TAPR/TICC/docs/images/TICC-test-setup.jpg

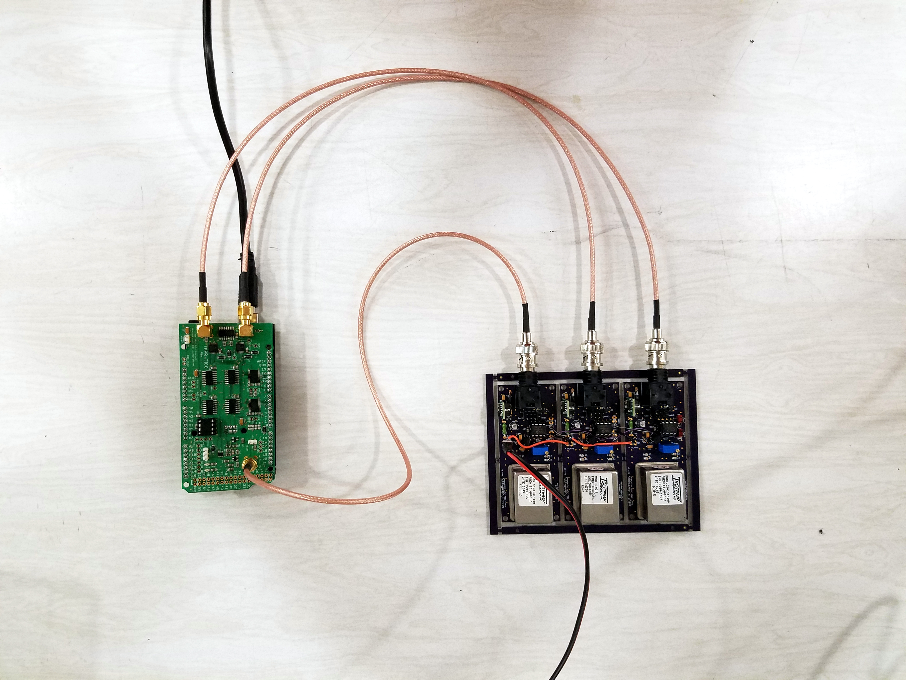
docs/images/TICC-test-setup.jpg
