TAPR/TICC/docs/images/PulsePuppy-Multi_medium.jpg

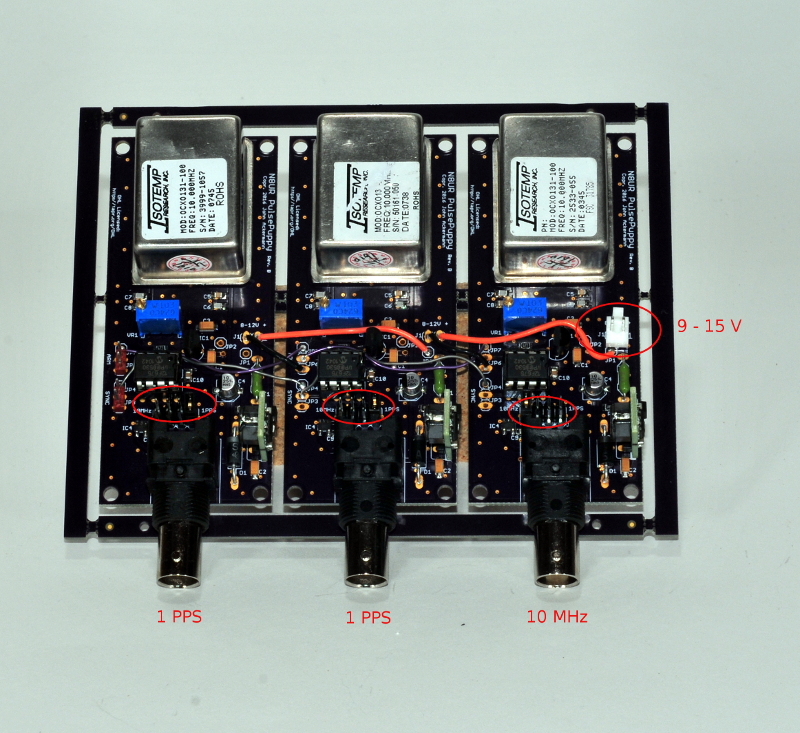
docs/images/PulsePuppy-Multi_medium.jpg
