TAPR/TICC/docs/TICC_architecture.md

# TICC Architecture Documentation

**Date:** November 16, 2025 

## Overview
This document describes the architecture and implementation details of 
the TAPR TICC timestamping counter hardware and firmware. The TICC uses 
Texas Instruments TDC7200 chips to provide precise timestamp measurements 
with picosecond accuracy.  It is a little disorganized but attempts to
describe all the important details of the system.

This firmware version includes performance optimizations applied after 
detailed oscilloscope-based performance analysis. Current measured 
performance:
- **Event processing:** 566 µs (from INTB assertion to calculate_timestamp
    return)
- **Timestamp formatting:** 395 µs (ASCII conversion for text output)
- **Measured sustainable throughput:** 
  - 587 measurements/second @ 115200 baud (transmission-limited)
  - 765 measurements/second @ 230400 baud
  - New binary mode: 1285 measurements/second @ 230400 baud 

## Hardware
There are two TDC7200 chips on the board, one for each input channel.  
We use only a few of the TDC signal lines:
- START (event begins)
- STOP  (on 100 us boundary)
- INTB  (measurement complete)
- SPI 
- CLOCK (10 MHz from EXT_CLOCK)

The START signal is from the external device under test.  The STOP
signal is generated by the COARSE_CLOCK through a gating mechanism
described below.  COARSE_CLOCK is a 10 kHz (100 us) signal derived
from the external 10 MHz source.  COARSE_CLOCK provides timing in 
100 us increments and the TDC provides precise timing within those 
increments (in turn, it uses EXT_CLOCK for 100 ns resolution, and an
internal ring oscillator for fine precision of about 55 ps).

The falling edge of COARSE_CLOCK fires an interrupt service routine 
(ISR) on every tick that increments a variable called PICcount.  
PICcount represents the time in 100 us increments since system start, 
and provides the long-term timescale used to construct timestamps

The TDC7200 has two measurement modes.  Mode 1 provides measurement of
time intervals from 12 to 500 nanoseconds, which is not a wide enough
range for our requirements.  Mode 2 covers the range from 200 ns to 
about 6 ms and is the mode the TICC uses.  To ensure that the STOP signal 
(derived from COARSE_CLOCK) meets the 200 ns minimum period, a set of
logic gates blocks the COARSE_CLOCK tick from reaching the STOP pin for
three ticks (depending on relative phase, from 200 to 300 ns) of the 
EXT_REF clock after the START signal.

When the TDC chip sees the STOP pulse, it finishes counting, performs
a calibration routine, and asserts its INTB pin to signal that a 
measurement is ready.  The gated COARSE_CLOCK rising edge also fires 
an ISR on the Arduino that copies the PICcount value at that instant 
into the channel's PICstop variable.

Note that PICcount increments on the falling edge of COARSE_CLOCK rather
than the rising edge.  This avoids a possible race condition were PICcount
to increment at the same instant one of the PICstop ISRs is firing.

The captured PICstop variable is combined with the computed time-of-flight 
(interval from TDC START to STOP signals) as described below.

### Notes: 
  - The STOP signal latches high until the TDC asserts INTB, so that STOP
    and the ISR never see more than one rising edge per measurement.
  - INTB assertion delay after STOP: 2330 ns to 2472 ns (per datasheet).

### TOF Range Constraints
The result of this is that the time interval (called time of flight, or
"tof") measured by the TDC chip is nominally within the range 200 ns to
100.3 us (300,000 to 100,300,000 picoseconds) and will fit within a 32
bit variable.

## Deriving TOF from TDC7200 data
The below is from the TDC7200 datasheet and explains the calculations 
used in "mode 2" to derive the time-of-flight from the registers that 
are transferred from the chip via SPI to the host processor.

8.4.1 Calibration
The time measurements performed by the TDC7200 are based on an internal 
time base which is represented as the LSB value of the TIME1 to TIME6 
results registers. The typical LSB value can be seen in Electrical
Characteristics. However, the actual value of the LSB can vary depending 
on environmental variables (temperature, systematic noise, etc.). This 
variation can introduce significant error into the measurement result.
There is also an offset error in the measurement due to certain internal
delays in the device.  In order to compensate for these errors and to 
calculate the actual LSB value, calibration needs to be performed.

The TDC7200 calibration consists of two measurement cycles of the 
external CLOCK. The first is a measurement of a single clock cycle 
period of the external clock; the second measurement is for the number 
of external CLOCK periods set by the CALIBRATION2_PERIODS in the 
CONFIG2 register. The results from the calibration measurements are 
stored in the CALIBRATION1 and CALIBRATION2 registers.

The two-point calibration is used to determine the actual LSB in real 
time in order to convert the TIME1 to TIME6 results from number of 
delays to a real time-of-flight (TOF) number. As discussed in the next 
sections, the calibrations will be used for calculating time-of-flight 
(TOF) in measurement modes 1 and 2.
 
8.4.2.2 Measurement Mode 2
In measurement mode 2, the internal ring oscillator of the TDC7200 is 
used only to count fractional parts of the total measured time. As 
shown in Figure 18, the internal ring oscillator starts counting from 
when it receives the START signal until the first rising edge of the 
CLOCK. Then, the internal ring oscillator switches off, and the Clock 
counter starts counting the clock cycles of the external CLOCK input
until a STOP pulse is received. The internal ring oscillator again starts 
counting from the STOP signal until the next rising edge of the CLOCK.

8.4.2.2.1 Calculating Time-of-Flight (TOF) (Measurement Mode 2)
The time-of-flight (TOF) between the START to the nth STOP can be 
calculated using Equation 2:

TOF_n = normLSB(TIME1 - Time(n-1)) + (CLOCK_COUNT1(n))(CLOCKperiod)
normLSB = CLOCKperiod / calCount
CalCount = (CALIBRATION2 - CALIBRATION1) / ((CALIBRATION2_PERIODS)-1)

where:
 • TOFn [sec] = time-of-flight measurement from the START to the nth 
   STOP
 • TIME1 = time 1 measurement given by the TDC7200 register address 0x10
 • TIME(n+1) = (n+1) time measurement, where n=1 to 5( TIME2 to TIME6 
   registers)
 • normLSB [sec] = normalized LSB value from calibration
 • CLOCK_COUNTn = nth clock count, where n=1 to 5( CLOCK_COUNT1 to 
   CLOCK_COUNT5)
 • CLOCKperiod [sec] = external CLOCK period
 • CALIBRATION1 [count] = TDC count for first calibration cycle
 • CALIBRATION2 [count] = TDC count for second calibration cycle
 • CALIBRATION2_PERIODS = setting for the second calibration; located 
   in register CONFIG2 (2)

For example, assume the time-of-flight between the START to the 1st 
STOP is desired, and the following readouts were obtained:
 • CALIBRATION2 = 23133 (decimal)
 • CALIBRATION1 = 2315 (decimal)
 • CALIBRATION2_PERIODS = 10
 • CLOCK = 8MHz
 • TIME1 = 2147 (decimal)
 • TIME2 = 201 (decimal)
 • CLOCK_COUNT1 = 318 (decimal)
 
Therefore, the calculation for time-of-flight is:
 
calCount = (23133 - 2315) / (10 -1)
CLOCKperiod = 1 / 8 MHz = 5.4e-11
normLSB = (1/8 MHz) / calCount = 5.4e-11
TOF1 = (2147)(5.4e-11) + (318)(1/8MHz) - 201(5.40e-11)
TOF1 = 39.855 us

## System Configuration Tweaks

### Propagation Delay and FUDGE0
These options allow setting two delays (specified in picoseconds)
on a per-channel basis.  They are primarily intended to allow equalizing
the delay between the channels.  The two values are added together to
create a single per-channel correction.  The default is 0 for both values.

### fixed_TIME2
This is an experimental option that *might* allow lower jitter levels.  
The TDC7200 generates its time-of-flight from the START to STOP pulse 
by combining three measurements: (a) the period from the START signal 
until the next tick of the 100 ns clocki (TIME1); (b) the number of 
100 ns clock periodsi (CLOCK1); and (c) the period from the STOP signal 
until the next 100 ns tick (TIME2).  The TIME1 and TIME2 values are based 
on the free-running ring oscillator.

The TICC hardware creates a fixed phase relationship between the 100 ns 
clock and the STOP signal that is based on the 100 us COARSE clocki -- 
the delay from STOP to the next 100 ns tick is fixed, at least for a 
given power cycle and in practice tends to remain very constant.  
However, because the ring oscillator is free-running and calibrated 
after the fact, TIME2 tends to vary over a small range.  However, that 
variation is noise and not a "real" component of the timestamp 
calculation.

The theory is that instead of measuring TIME2 for each measurement, 
we could simply substitute a fixed, reasonable value.  That should 
reduce the jitter in the time-of-flight and consequently the timestamp 
results.

Setting fixed_TIME2 to a non-zero value will plug that value into the
calculation in place of the measured TIME2 value.  Tests show that this 
does result in a slightly lower noise floor, but this feature has not 
been tested over a wide range of conditions.  *USE AT YOUR OWN RISK!*

### Time Dilation Correction
**Background:** The TDC7200 uses an internal ring oscillator (63 
inverters in a feedback loop) to measure fractional time within 100 ns 
clock periods. Each measurement cycle includes calibration to determine 
the ring oscillator's effective LSB (least significant bit) value. In 
theory, this calibration should perfectly normalize measurements 
regardless of environmental variations.

**Observed behavior:** Empirical testing reveals a systematic "sawtooth" 
pattern in timestamps that correlates with the measurement phase within 
the 100 µs coarse clock cycle. This sawtooth has a period that depends on
the relative frequency drift between the DUT and the reference, and has
an amplitude typically of ~100-250 picoseconds.

**Hypothesis - Time-Dependent Ring Oscillator Characteristics:**
The TDC7200 datasheet (Mode 1 specifications) shows that ring oscillator 
standard deviation increases super-linearly with measurement duration:
- 200 ns measurement: ~40 ps std dev
- 1 µs measurement: ~120 ps std dev (3× worse for 5× longer duration)

In Mode 2, TIME1 measurements range from ~6 ns to ~106 ns as the START 
signal phase sweeps relative to the 100 ns reference clock. The varying 
TIME1 duration may introduce systematic measurement errors due to:

1. **Non-linear noise characteristics:** Ring oscillator accuracy degrades 
   non-linearly with measurement duration
2. **Calibration limitations:** Calibration measures a fixed 2 µs span 
   (20 periods × 100 ns), while actual TIME1 measurements vary from 
   6-106 ns.  The ring oscillator may behave differently at these 
   timescales.
3. **Startup transients:** Short measurements may be affected by ring 
   oscillator startup effects not captured in the longer calibration 
   cycles.

**The time_dilation correction (default: 2500):**
The firmware applies an empirical correction factor called 
`time_dilation` that adjusts the calibration calculation:
```cpp
scale = 1,000,000 - time_dilation;  // 997,500 for default
calCount = (cal_diff × scale) / denom;
```

This 0.25% scaling adjustment effectively modifies the computed 
normLSB and has been empirically determined (across dozens of TDC7200 
units) to flatten the sawtooth pattern.

**Note:** While the physical mechanism is not fully understood, the 
time_dilation correction is consistently effective across all tested 
hardware and reference sources. The value of 2500 appears to be optimal 
for the TDC7200 chips in production TICC units.

### Falling Edge Trigger Option Removed
Earlier firmware versions supported the option to change the trigger
edge from rising to falling.  It turns out that this doesn't work
because the stop gate triggers only on rising edge regardless of the
TDC trigger edge.  This means that if the TDC triggers on the falling
edge of the pulse, the stop gate will trigger *before* the TDC, with
the result that the STOP signal timing is off; it's even possible that
STOP could arrive *before* START.

Consequently, **the trigger edge configuration option has been removed
from the 2025 firmware release.**

## Main Loop Processing
On each iteration, the main loop checks whether either or both TDC chips
have their INTB signals asserted to indicate they have completed a
measurement.  Because of the variable delay from the STOP signal until 
INTB assertion, there is no guarantee if both channels are active which 
one will be processed first, and thus timestamps could be printed out 
of order or out of channel sequence.

The processing loop is designed to correct this by checking INTB status
multiple times for both channels, and when both are present outputting the
earlier timestamp first.

### Timestamp Generation
Timestamps are generated by combining the captured PICstop value with the
with the tof generated by the TDC chip.  To be precise, since PICstop 
represents the coarse tick *after* the START event, tof is *subtracted* 
from (PICstop * 100 us) to yield the timestamp.  The timestamp is stored 
in a struct consisting of a 32 bit int for the integer seconds and a 64 
bit unsigned int for the fractional part with 1 picosecond resolution 
(12 decimal places).

### Performance Characteristics
Performance measurements updated October 2025 based on testing 
using both measurments using another TICC and oscilloscope
verification methods.

**Loop Timing:**
- **Idle loop:** ~52 µs (no INTB asserted, no serial data)
  - Breakdown: Serial check, reference clock watchdog, INTB checks, 
    loop overhead

**Single-Channel Active (per timestamp):**
- **Calculation phase:** ~580 µs (complete processing from INTB assert to 
  calculate_timestamp() return)
  
  Measured via oscilloscope with INTB and GPIO timing instrumentation:
  - Loop detection delay: ~28 µs (5%) - INTB assert to function entry
  - Function entry to ready_next(): ~452 µs (78%)
    * channel->read() function: ~433 µs total
      - SPI reads: ~82 µs (two auto-increment transactions)
      - TOF calculation: ~294 µs (two 64-bit divisions, two 64-bit 
        multiplications,
        plus 32-bit operations)
      - tdc_ack_int(): ~57 µs (SPI read + write to clear interrupt status)
    * ready_next() SPI write: ~19 µs
  - Post ready_next() processing: ~100 µs (17%)
    * Timestamp accumulation (lines 30-68 in calculate_timestamp())
    * 64-bit multiplication (dcount × pictick_ps): ~800-1200 cycles
    * 64-bit addition/subtraction with carry/borrow handling
    * PICstop reads with interrupt protection
    * Note: Negative path with division (~244-331 µs) never encountered as 
      delta_ps is always positive (see Timestamp Calculation below)
  
- **Print phase:** ~571 µs measured (text timestamp mode, typical 
  configuration)
  - Formatting: ~395 µs (ASCII conversion using optimized reciprocal 
  division)
  - Serial.write(): ~167 µs at low rates (<480 Hz)
  
  **Rate-dependent blocking behavior (115200 baud):**
  - At low rates (<480 Hz), UART buffer drains faster than data arrives
  - At medium rates (480-585 Hz): Blocking increases as buffer stays fuller
  - At high rates (>585 Hz): System cannot sustain, buffer fills, events 
    overlap
  - Blocking time depends on buffer fullness, which varies with measurement
    rate
  
  **Transmission happens asynchronously:** The 64-byte UART TX buffer 
  transmits in hardware after Serial.write() returns. Actual transmission
  time (~1.7 ms for ~20 bytes @ 115200 baud) overlaps with next event's 
  processing.
  
- **Total per timestamp:** ~1137 µs (566 µs process + 571 µs print) at 
  low rates
  - At high rates (>480 Hz), print time increases due to Serial.write() 
  blocking

**SPI Optimization:**
- 202510xx firmware uses "autoincrement" mode to combine
  SPI reads into fewer events as well as lower-overhead CSB toggling.
- Before SPI optimizations: ~700 µs processing time in channel->read()
- Afgter SPI optimization: ~580 us processing time
  (savings: 120 µs per measurement (17% faster processing)

**Both-Channels Active (per pair):**
- **Calculation phase:** ~1132 µs (both channels, 566 µs each)
- **Print phase:** ~1142 µs (two timestamps, 571 µs each @ low rates)
- **Total per pair:** ~2274 µs (at low rates where Serial.write() 
  blocking is minimal)

**Throughput:**
- **Single-channel text mode:**
  - @ 115200 baud: **587 Hz maximum**
    * Limited by UART transmission time (~1740 µs for ~20 bytes)
  - @ 230400 baud: **765 Hz maximum**
    * Formatting optimization provides real benefit at higher baud rates
    * Better balance between processing, formatting, and transmission
  - **Rate-dependent behavior (validated via oscilloscope):**
    * <480 Hz: Stable, minimal Serial.write() blocking (~167 µs)
    * 480-587 Hz: Serial.write() blocking increases as buffer stays fuller
    * >587 Hz @ 115200: System cannot sustain, buffer continuously full
    * >765 Hz @ 230400: System cannot sustain
  
- **Binary timestamp single-channel:**
  - @ 230400 baud: 1285 measurements/second sustained (measured)
  - Much better throughput due to complete lack of formatting plus
    smaller output (12 bytes vs 35 bytes)
  - Processing speedup has greater impact with shorter output time
  
- **Maximum processing speed:**
  - Without output: ~1400-1550 measurements/second theoretical
  - Based on 580 µs processing + minimal idle time
  - Consistent with measured ~1400 measurements/second in loop speed tests

**Speed Test Procedure:**
Speed test code is included in the hardware-timing-benchmarks branch
available at github.

**Impact of Baud Rate on Throughput:**

At maximum sustainable rates, throughput is limited by UART transmission 
capacity.  The 64-byte UART TX buffer must drain fast enough to accept 
new data.

| Baud Rate | Buffer Drain Rate | Measured Throughput | Improvement |
|---|---|---|---|
| 115200 (default) | 87 µs/byte | **587 Hz** | baseline |
| 230400 | 43.5 µs/byte | **765 Hz** | **+30%** |

**Analysis:**

**@ 115200 baud (587 Hz):**
- Transmission time: ~1740 µs for ~20 bytes (dominates)
- Processing + formatting: 961 µs (566 + 395)
- **Transmission-limited:** UART cannot drain fast enough
- Formatting optimization saved 285 µs, but Serial.write() blocking 
  increased by 285 µs to compensate - no net throughput gain

**@ 230400 baud (765 Hz):**
- Transmission time: ~870 µs for ~20 bytes (faster)
- Processing + formatting: 961 µs (same)
- **Better balance:** Processing and transmission more evenly matched
- Period = 1307 µs = 566 (process) + 395 (format) + 346 (blocking)
- 30% higher throughput than 115200 baud due to faster transmission

**Binary Mode provides much better throughput:**
- Only 12 bytes vs ~20-30 bytes per timestamp
- **No formatting overhead** (~395 µs saved) - binary mode skips ASCII 
  conversion entirely
- Measured: 1285 measurements/second @ 230400 baud
- **~2× faster than text mode** primarily due to eliminating formatting 
  overhead

**Bottleneck Analysis:**

In text mode @ 115200 baud (at low rates <480 Hz):
- Event processing: 566 µs (50%)
- Timestamp formatting: 395 µs (35%)
- Serial.write() buffer copy: 167 µs (15%)
- Total: ~1128 µs per event

In text mode @ 115200 baud (at maximum sustainable rate, 587 Hz):
- Event processing: 566 µs
- Timestamp formatting: 395 µs
- **Serial.write() blocking: ~743 µs** (waits for UART buffer to drain)
- Total cycle: ~1704 µs (limited by transmission time ~1740 µs for 
  ~20 bytes)
- System is transmission-limited; formatting optimization doesn't improve 
  throughput

In binary mode @ 230400 baud:
- Event processing: ~580 µs (read TDC + pack binary)
- **No formatting:** 0 µs (just copy raw binary values)
- Serial.write(): Minimal blocking (12 bytes drains quickly)
- Total: ~600-700 µs per event
- Maximum sustainable rate: ~1285 Hz

**Key Findings:**

1. **@ 115200 baud:** Transmission-limited at 587 Hz
   - Formatting optimization doesn't improve throughput
   - UART transmission time (~1740 µs) exceeds processing+formatting 
     (961 µs)
   - Serial.write() blocking absorbs any CPU time savings

2. **@ 230400 baud:** Better balance at 765 Hz (+23% vs pre-optimization)
   - Transmission time (~870 µs) closer to processing+formatting (961 µs)
   - Formatting optimization provides real throughput benefit
   - System approaching CPU-limited region

3. **Binary mode (1285 Hz):** Eliminates formatting overhead entirely
   - Processing only: ~580 µs
   - Minimal serial overhead (12 bytes)
   - ~2× text mode throughput by skipping 395 µs formatting

## Timestamp Calculation
The timestamp calculation uses a mixed-radix accumulator approach:

- **Structure:** `Timestamp64 = {int32_t seconds, uint64_t picos}`
- **Algorithm:** `delta_ps = dcount×PICTICK_PS - (tof_k - tof_{k-1})`
- **Accumulation:** `timestamp.picos += delta_ps` with automatic 
  carry/borrow to seconds
- **Precision:** Full picosecond precision (12 decimal places)
- **Performance:** 1400-1550 measurements/second maximum processing rate

**Why delta_ps is always positive:** The code includes a negative path 
(lines 53-64 in timestamps.cpp) with expensive 64-bit division/modulo 
operations (~1500-2500 cycles each), but this path is never executed in 
practice. Since `ready_next()` clears INTB ~480 µs after an event's 
STOP signal (measured via oscilloscope), and PICcount increments every 
100 µs, any subsequent event on the same channel will capture a PICstop 
value at least 4-5 ticks higher, making `dcount ≥ 4-5`. With dcount ≥ 4, 
`delta_ps = dcount×100,000,000 ps - (tof difference)` is always positive 
since even dcount=4 yields 400 million ps, far exceeding the maximum tof 
difference of ~100 million ps. This makes delta_ps strongly positive in 
all realistic scenarios.

**64-bit arithmetic overhead (measured):** The complete 64-bit arithmetic 
overhead dominates event processing time, totaling ~450 µs (77% of 566 µs 
total):
- **TOF calculation in read():** ~350 µs (measured via GPIO instrumentation)
  - Two 64-bit multiplications: ~100-150 µs combined
  - Two 64-bit divisions: ~110-145 µs combined (one optimized with 
    uint32_t divisor)
  - 32-bit operations and overhead: ~50-100 µs
  - This is the largest single component of processing time

- **Timestamp accumulation after ready_next():** ~100 µs
  - One 64-bit multiplication (dcount × pictick_ps): ~800-1200 cycles
  - Multiple 64-bit additions/subtractions with carry/borrow handling

The negative path with additional division/modulo (~244-331 µs) in the 
accumulation logic is unreachable code in normal operation as delta_ps 
is always positive.

## Performance Optimization History
### SPI Read Optimizations (Implemented October 2025)

The firmware implements two significant SPI optimizations for reading 
TDC7200 registers:

1. **Auto-increment mode:** Uses TDC7200's built-in auto-increment feature 
   to read sequential registers in fewer SPI transactions (2 instead of 5)
2. **Direct port manipulation:** Replaces digitalWrite() calls with direct 
   port access for CSB control, reducing overhead from ~4 µs to ~125 ns 
   per operation

**Results:**
- Isolated SPI reads: 44% faster (236 µs → 132 µs in synthetic tests)
- Real-world processing: 17% faster (700 µs → 580 µs with live signals)
- Savings: 120 µs per measurement
- At maximum rate (1400/sec): Frees 168 ms/sec of CPU time

### TOF Calculation Optimization (Implemented October 2025)

The TOF (time-of-flight) calculation in `tdc7200.cpp` converts raw TDC7200 
register values to calibrated picosecond time-of-flight values. This 
involves 64-bit arithmetic which is expensive on 8-bit AVR.

**Measured performance (via GPIO instrumentation):**
- Total read() function time: ~433 µs
  - SPI reads (2 auto-increment transactions): ~82 µs (19%)
  - TOF calculation: ~294 µs (68% - dominated by 64-bit operations)
  - tdc_ack_int(): ~57 µs (13% - SPI read + write to clear interrupt)

**TOF calculation breakdown (~294 µs):**
- Two 64-bit multiplications: ~100-150 µs combined
  - cal_diff × scale
  - num × 1000000
- Two 64-bit divisions: ~110-145 µs combined (one optimized with uint32_t 
  divisor)
  - cal_prod / denom (small constant)
  - num / calCount (optimized 64-bit/32-bit division)
- 32-bit operations and overhead: ~40-80 µs

**Optimization applied - calCount type change:**
- Changed calCount from `int64_t` to `uint32_t` for the divisor in 
  ring_ps calculation
- Enables faster 64-bit/32-bit division instead of 64-bit/64-bit division
- Safe based on TDC7200 physical limits: With 55 ps LSB and max 40 
  calibration periods, calCount maximum is ~1.8 billion (well within 
  uint32_t range)
- Measured savings: ~14 µs
- Provides modest but measurable improvement with zero risk

**Note:** The TOF calculation remains the largest single component of
event processing time (~350 µs of 566 µs total). Further optimization 
would require approximate methods that risk precision loss, which is 
unacceptable for picosecond-level timing.

### Formatting Optimization (Implemented October 2025)

The `print_timestamp()` function in `print.cpp` formats picosecond 
timestamps to ASCII.  On 8-bit AVR, software division is expensive 
(~500 cycles per operation), making digit extraction the primary 
bottleneck.

**Optimization approach:** Reciprocal multiplication + lookup table

1. **Reciprocal multiplication for division:**
   - Replace `x / 10` with `(x * 0xCCCCCCCD) >> 35` (~50 cycles vs ~500 
   cycles)
   - Replace `x / 1000` with `(x * 0x10624DD3) >> 38`
   - Mathematically exact for all 32-bit values - no precision loss
   - Magic constants: `ceil(2^shift / divisor)`

2. **Two-digit lookup table:**
   - Pre-computed PROGMEM table for pairs "00"-"99" (200 bytes)
   - Converts 2 digits via lookup instead of 2 divisions

3. **Optimized to6digits() function:**
   - Splits 6-digit number into two 3-digit groups via fast division by 1000
   - Each group: 2-digit lookup + 1 single digit conversion
   - Uses 4 fast divisions + 2 lookups (called twice per timestamp)

**Performance (measured via GPIO instrumentation):**
- Formatting time: ~395 µs (down from 680 µs unoptimized)
- Serial.write() blocking: ~167 µs (at low rates <480 Hz)
- Total print time: ~571 µs
- Memory cost: 200 bytes PROGMEM (negligible)
- No precision loss: mathematically exact output

**Throughput impact:**
- @ 115200 baud: 587 Hz (transmission-limited - no improvement from 
  formatting optimization)
- @ 230400 baud: 765 Hz (30% higher than 115200 due to faster transmission)
- Higher baud rates show greater benefit as transmission time becomes 
  less dominant

### Performance Bottleneck Analysis

Comprehensive testing revealed significant integration overhead when 
components operate together. Isolated component tests summed to ~232 µs, 
but actual processing measures ~580 µs—60% overhead from integration 
effects.

**Current Bottlenecks (in priority order):**

Based on oscilloscope measurements with INTB and GPIO timing 
instrumentation (October 2025):

1. **64-bit math operations (~394 µs, 70%)** ← Dominant bottleneck
   - **TOF calculation (in read()):** ~294 µs (52% of total processing)
     * Two 64-bit multiplications: ~100-150 µs combined
     * Two 64-bit divisions: ~110-145 µs combined (one optimized with 
       uint32_t divisor)
     * 32-bit operations: ~40-80 µs
     * Measured via GPIO instrumentation within read() function
   - **Timestamp accumulation (after ready_next()):** ~100 µs (18%)
     * One 64-bit multiplication (dcount × pictick_ps, ~800-1200 cycles)
     * Multiple 64-bit additions/subtractions with carry/borrow handling
   - **Total 64-bit overhead: ~394 µs** of 566 µs processing time
   - Expensive on 8-bit AVR architecture (no native 64-bit support)
   - Further optimization requires approximate methods that risk 
     precision loss

2. **SPI operations (~158 µs, 28%)**
   ✅ Already optimized
   - read() SPI reads: ~82 µs (two auto-increment transactions)
   - tdc_ack_int() SPI: ~57 µs (read + write to clear interrupt)
   - ready_next() SPI: ~19 µs
   - Auto-increment mode + direct CSB port manipulation
   - Further optimization unlikely

3. **Loop detection delay (~28 µs, 5%)**
   - Time from INTB assertion to calculate_timestamp() entry
   - Includes: Serial check, reference clock check, INTB digitalRead, 
     LED operations
   - Small overhead, difficult to reduce further

**Testing Methodology:** Performance measurements used three 
complementary methods:
- Two-TICC precision timing (picosecond accuracy) for isolated component 
  tests
- Oscilloscope pulse width measurements for real-world verification
- **GPIO timing instrumentation (October 2025):** Definitive measurements 
  using INTB and GPIO (A0) pins with oscilloscope to measure exact timing 
  from INTB assertion through calculate_timestamp() return, revealing true 
  integration overhead

The GPIO instrumentation method provides the most accurate real-world 
measurements and supersedes earlier estimates based on isolated component 
timing.

See `docs/development_docs/SPI_OPTIMIZATION_FINDINGS.md` and 
`docs/development_docs/HARDWARE_TIMING_TEST_RESULTS.md` for detailed 
analysis.

## Data Types and Overflow Periods

| Variable | Type | Range/Overflow Period |
|---|---|---|
| **PICcount** | int64_t | Coarse counter, 100 µs per tick<br>Overflow: ~2.9×10¹¹ years (effectively never) |
| **PICstop** | int64_t | Captured PICcount value per event<br>Same range as PICcount |
| **tof** | int32_t | TDC7200 time-of-flight in picoseconds<br>Observed range: ~246,000 to 100,200,000 ps (see TOF Range Constraints)<br>Can hold ±2.15 billion ps (~2.15 seconds) |
| **timestamp.seconds** | int32_t | Accumulated integer seconds<br>Overflow: ±68 years from epoch |
| **timestamp.picos** | uint64_t | Fractional part, 0..(10¹²-1) picoseconds<br>Automatically normalized to stay within one second |
| **dcount** | int64_t | Delta ticks between events (in `calculate_timestamp`)<br>Theoretical max: 9.22×10¹⁸ ticks (~29 million years)<br>Practical limit: 9.22×10¹³ ticks (~292 years) due to multiplication overflow |
| **delta_ps** | int64_t | Delta time in picoseconds (in `calculate_timestamp`)<br>Maximum value: 9.22×10¹⁸ ps (~292 years)<br>Overflow constraint from `dcount × pictick_ps` (100,000 ps/tick) |

## Binary Mode (High-Throughput)
Binary mode provides maximum throughput for high-speed data collection:

- **Output format:** PICstop (lower 32 bits) + tof (32 bits) + channel + CRC
- **PICstop truncation:** ~4.97 days before overflow
- **User responsibility:** Must detect rollover externally for long-duration
  captures
- **Performance:** 1285 measurements/second @ 230400 baud (measured)

## Pairing Logic (Two-Channel Modes)

### Channel Synchronization
Each channel sets `new_ts_ready` when a fresh timestamp is computed.

### Mode-Specific Pairing
#### Interval and 3-Cornered Hat Modes
- Print once per pair when both channels are ready (A→B order)
- Clear both flags after printing
- Prevents mixing new and old samples, which can appear as ±1 s artifacts

#### Timestamp Mode
- Prints in ordered pairs with one-sample latency
- Two successive samples (across either channel) form a pair
- If both channels are present: chA then chB order
- If both from same channel: that channel is printed twice
- Handles single-channel and mismatched-rate cases without timeouts or
  configuration

## 3-Cornered Hat chC Synthesis
The 3-Cornered Hat mode synthesizes a third channel (chC) from the two
physical channels:

- **chA and chB:** Printed as timestamps
- **chC:** Represents (B − A) but synthesized to look like a timestamp
- **Method:** Takes channel B's seconds and uses the signed delta fractional
  part
- **Benefit:** Avoids discontinuities at crossings and preserves
  three-corner-hat compatibility

## Printing Implementation (print.cpp)

The printing system converts picosecond-precision timestamps to ASCII text 
efficiently on the 8-bit AVR architecture. Performance is critical as 
formatting can dominate the total event processing time.

### Implementation Approach

**Core technique:** Avoid Arduino's printf (lacks 64-bit support) and use 
custom optimized routines:

1. **Split 64-bit picosecond fraction** into two 32-bit 6-digit chunks using reciprocal 
   multiplication to avoid 64-bit division
2. **Convert each 6-digit chunk** to ASCII using optimized digit extraction
3. **Format seconds** with configurable wraparound support
4. **Single Serial.write() call** per line for minimum overhead

### Key Optimizations (Implemented October 2025)

**1. Reciprocal multiplication for division:**
- Software division on AVR takes ~500 cycles per operation
- Replace `x / 10` with `(x * 0xCCCCCCCD) >> 35` (~50 cycles)
- Replace `x / 1000` with `(x * 0x10624DD3) >> 38` 
- Mathematically exact for all 32-bit values - no precision loss
- 10× faster than software division

**2. Two-digit lookup table:**
- Pre-computed PROGMEM table for digit pairs "00"-"99" (200 bytes)
- Converts 2 digits with single lookup instead of 2 divisions
- Used in optimized 6-digit conversion routine

**3. Optimized 6-digit conversion (to6digits):**
- Splits number into two 3-digit groups via fast division by 1000
- Each group: 2-digit lookup + 1 single digit
- Total: 4 fast divisions + 2 lookups vs 6 slow divisions (original)
- Called twice per timestamp for 12-digit fractional part

### Performance Characteristics

**Measured via GPIO timing instrumentation (wrap=2, 11 places):**
- Formatting time: ~395 µs
- Serial.write() blocking: ~167 µs (at low rates <480 Hz)
- Total print time: ~571 µs per timestamp

**Configurable options:**
- Decimal places: 0-12 (affects formatting time slightly)
- Wraparound digits: 0-9 (seconds field width)
- Channel name display

**Maximum sustainable throughput (text mode, measured):**
- **587 Hz @ 115200 baud** - transmission-limited (UART drain rate: 
  87 µs/byte)
- **765 Hz @ 230400 baud** - better balance between processing and 
  transmission

**Rate-dependent Serial.write() blocking:**
- At low rates (<480 Hz): Minimal blocking (~167 µs), buffer stays mostly 
  empty
- At medium rates (480-587 Hz): Blocking increases as buffer fills
- Above maximum rate: System cannot sustain, buffer continuously full

At high rates, Serial.write() blocks waiting for the 64-byte UART TX 
buffer to have sufficient space. Buffer drain rate (baud-dependent) 
determines maximum sustainable throughput when processing + formatting 
time is less than transmission time.

## Why Signed for Timestamp64.seconds
The seconds field uses signed integers for several important reasons:

- **Frequent subtraction operations:**<br>
  `period = ts − last_ts; interval = B − A`
- **Negative results:** Can occur and signed integers avoid underflow
- **Special-case handling:** Eliminates need for complex underflow logic
- **Range adequacy:** int32_t range (±68 years) is sufficient for all
  measurement scenarios
