TAPR/TICC/docs/images/TDC7200-mode2-description-1.png

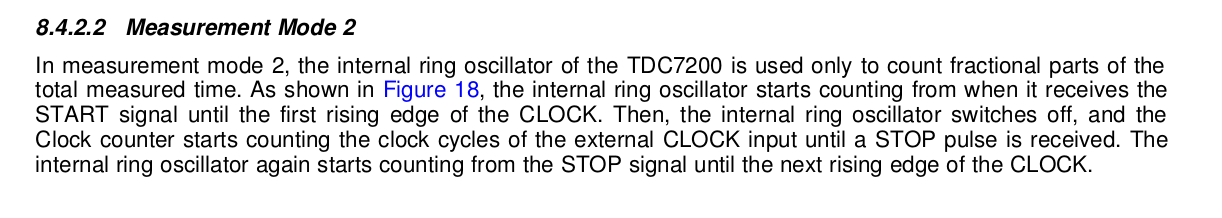
docs/images/TDC7200-mode2-description-1.png
