TAPR/TICC/docs/images/TDC7200-mode2-description-2.png

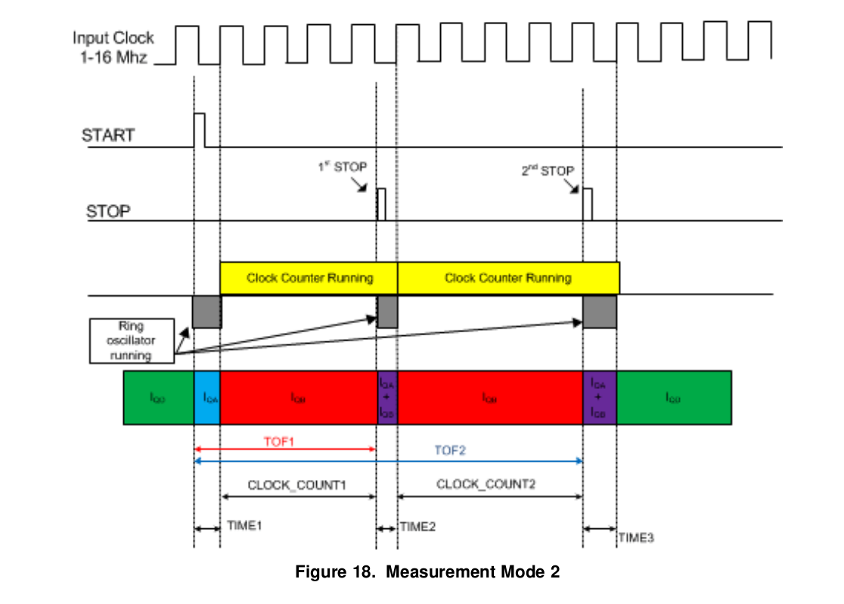
docs/images/TDC7200-mode2-description-2.png
