TAPR/TICC/docs/images/TDC7200-mode2-description-3.png

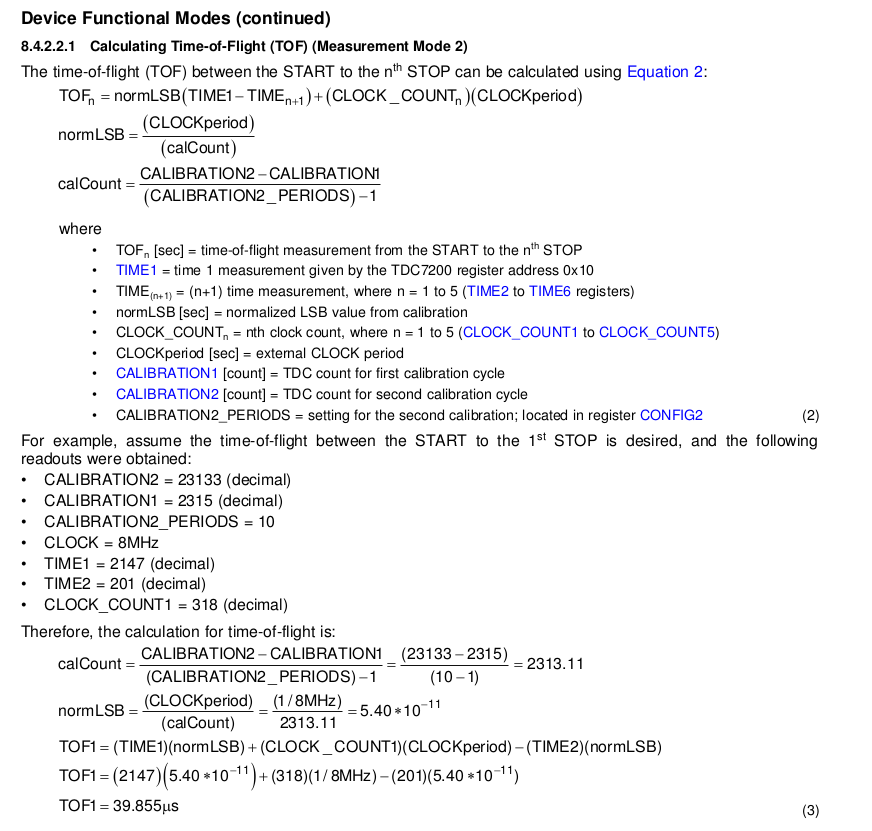
docs/images/TDC7200-mode2-description-3.png
