TAPR/TICC/docs/images/TICC-startup-1.png

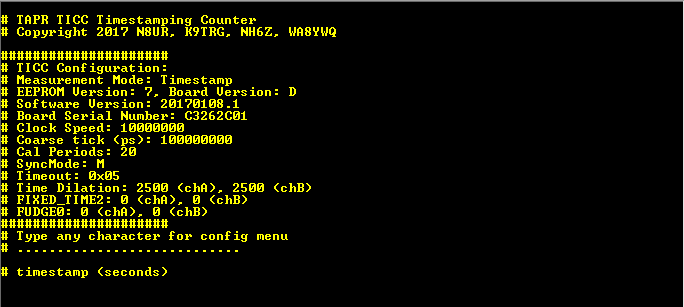
docs/images/TICC-startup-1.png
