TAPR/TICC/docs/images/TICC-startup-2.png

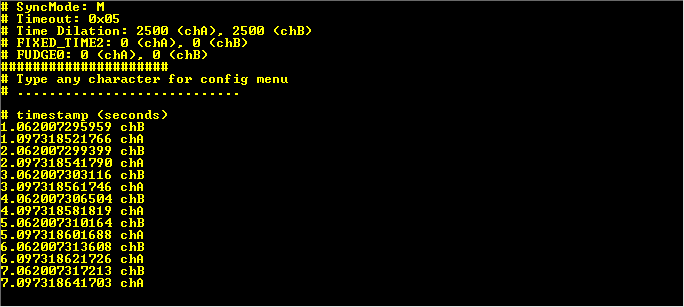
docs/images/TICC-startup-2.png
