TAPR/TICC/docs/images/TICC_rev_d_board_layer-1.png

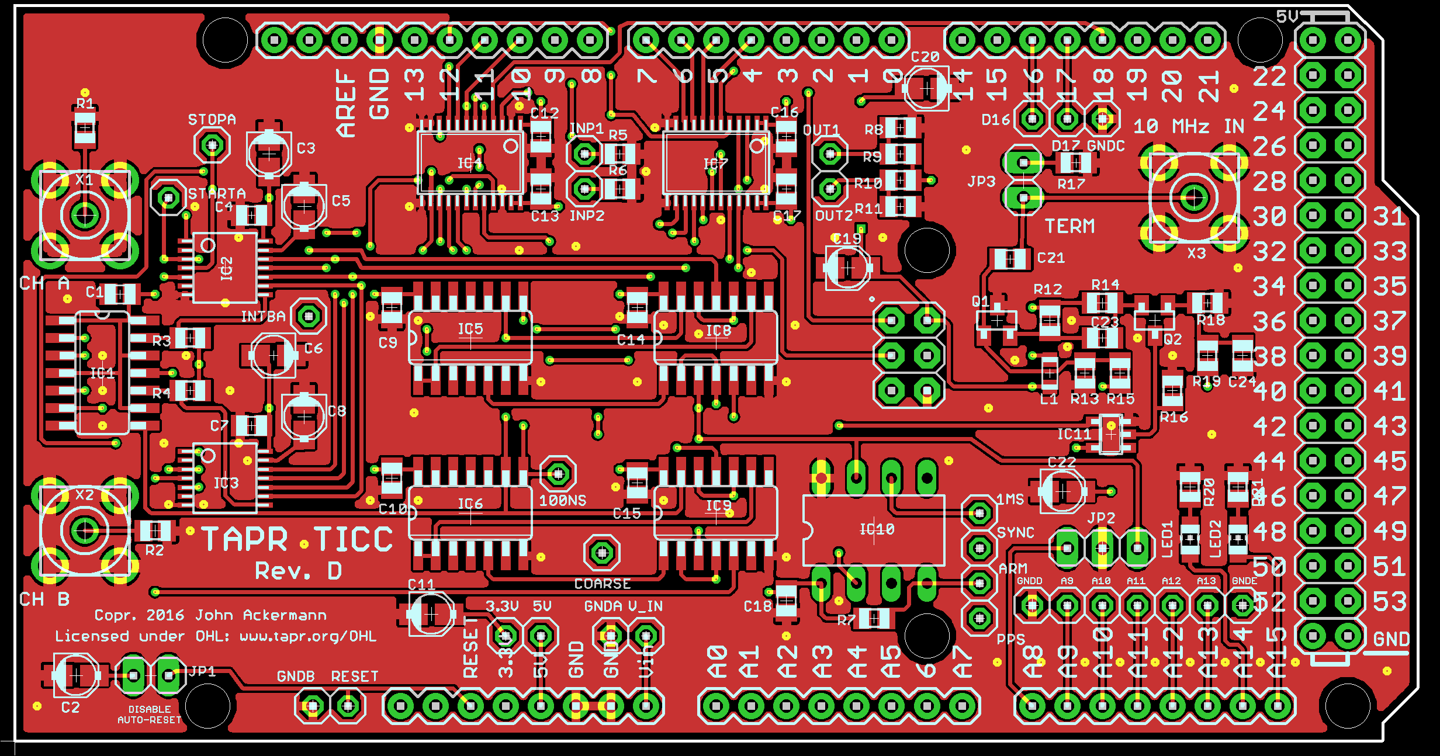
docs/images/TICC_rev_d_board_layer-1.png
