TAPR/TICC/docs/images/TICC_rev_d_board_layer-16.png

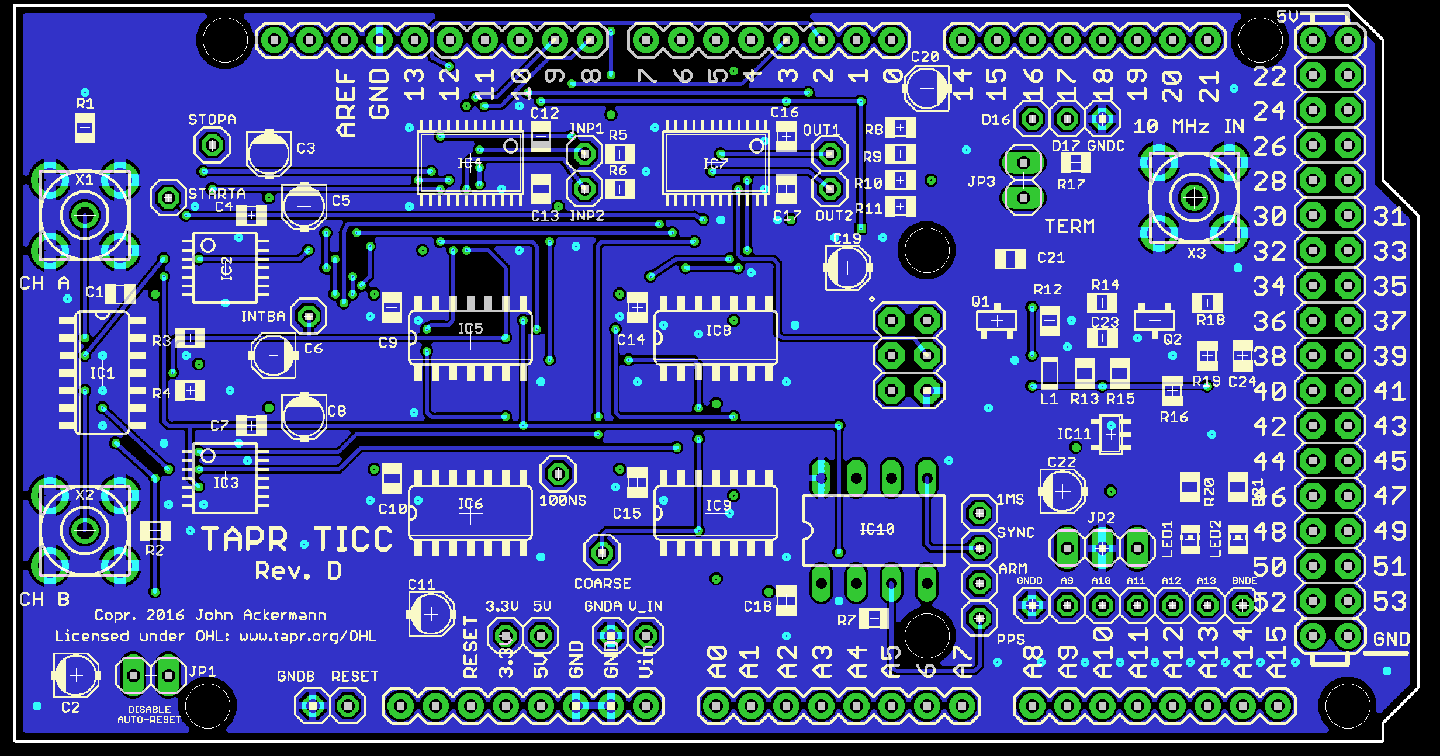
docs/images/TICC_rev_d_board_layer-16.png
