TAPR/TICC/docs/images/TICC_TDC2700_Block_Diagram_6March2016_rev_b.png

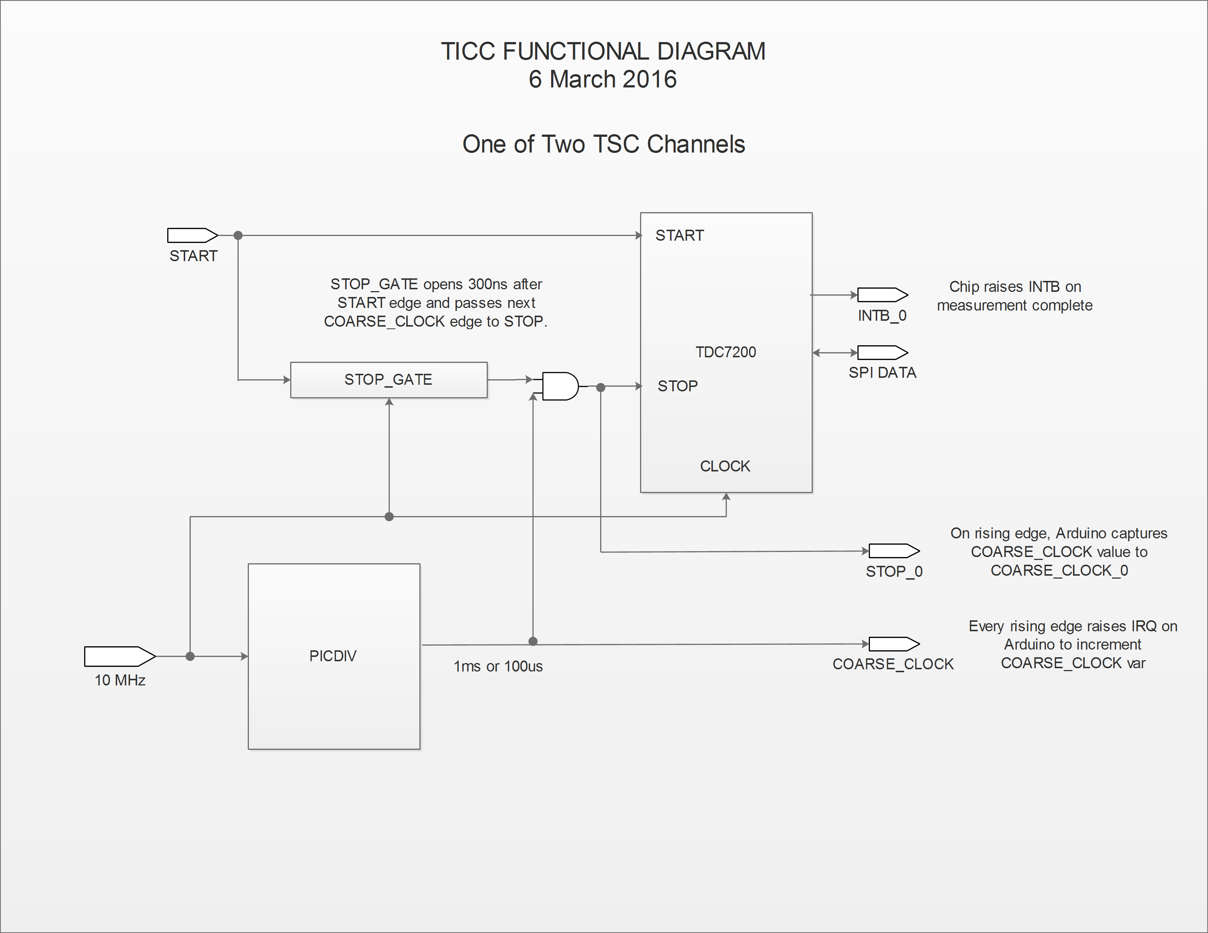
docs/images/TICC_TDC2700_Block_Diagram_6March2016_rev_b.png
