TAPR/TICC/docs/images/xloader.png

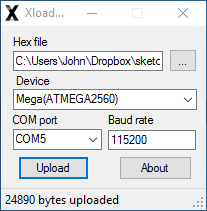
docs/images/xloader.png
