TAPR/TICC/multi-ticc/enclosure/images/multi-TICC-rack_large.png

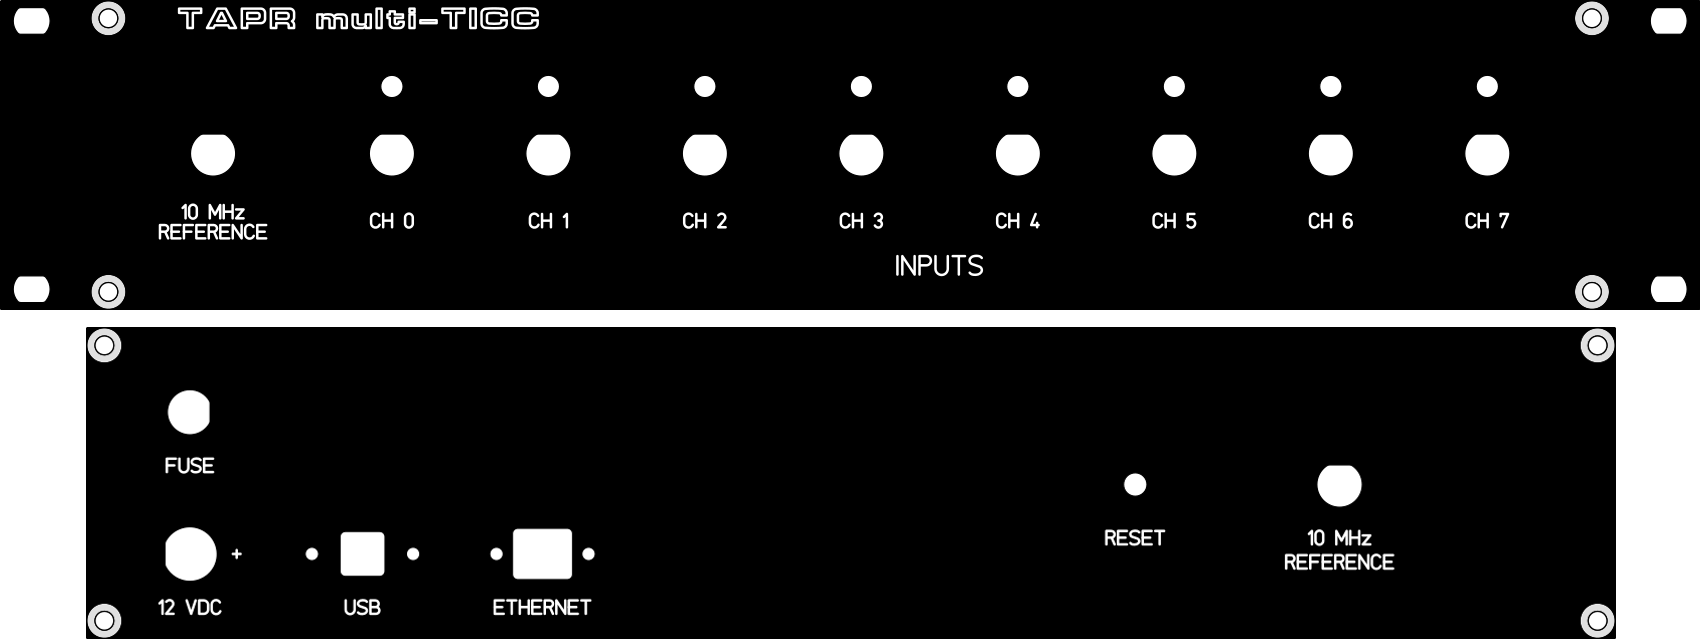
multi-ticc/enclosure/images/multi-TICC-rack_large.png
