TAPR/TICC/multi-ticc/enclosure/images/multi-TICC_3d_view.png

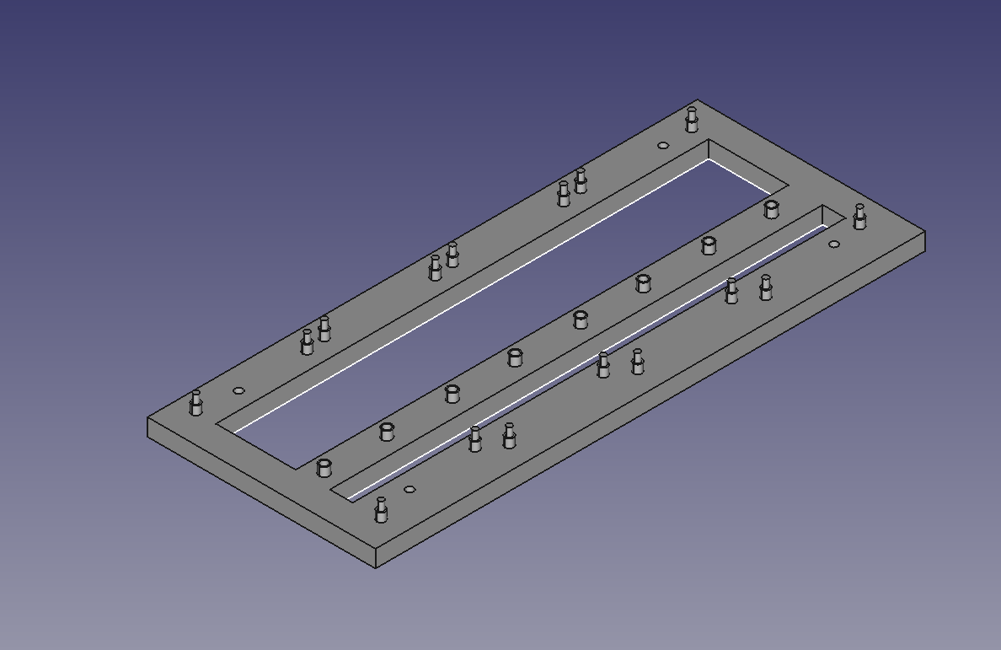
multi-ticc/enclosure/images/multi-TICC_3d_view.png
