TAPR/TICC/multi-ticc/enclosure/images/multi-TICC_frame_dimensions.png

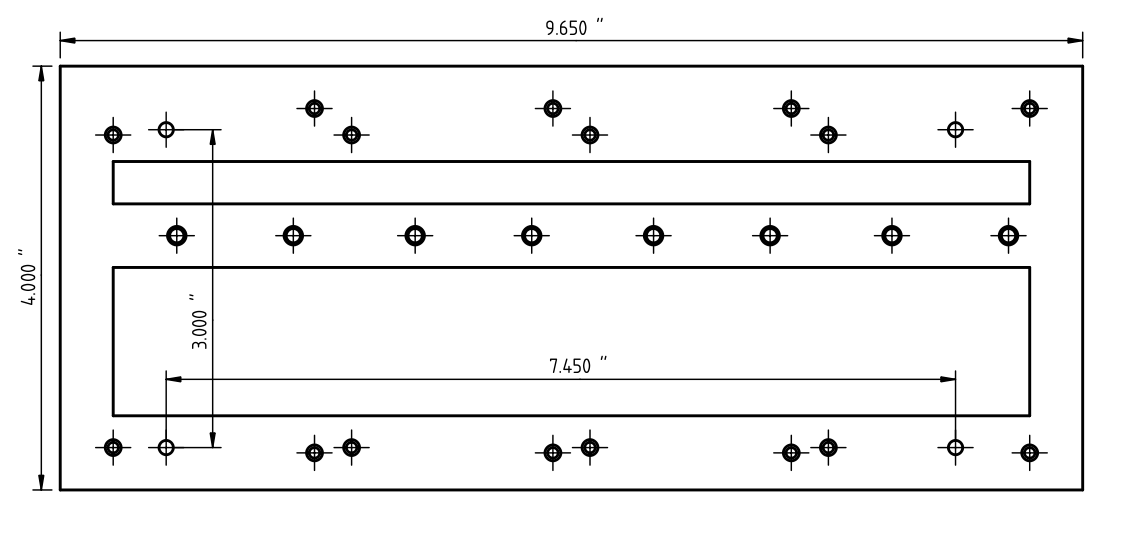
multi-ticc/enclosure/images/multi-TICC_frame_dimensions.png
