TAPR/TICC/multi-ticc/enclosure/3d_print/multi-ticc-v2.FCStd

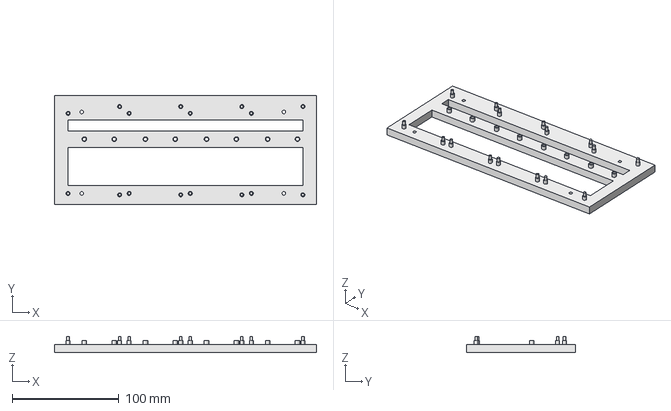
[picture p16: CAD file, 2020-04-12]
multi-ticc/enclosure/3d_print/multi-ticc-v2.FCStd
245.1 x 101.6 x 15.2 mm
