TAPR/TICC/multi-ticc/enclosure/3d_print/multi-ticc-v1.FCStd

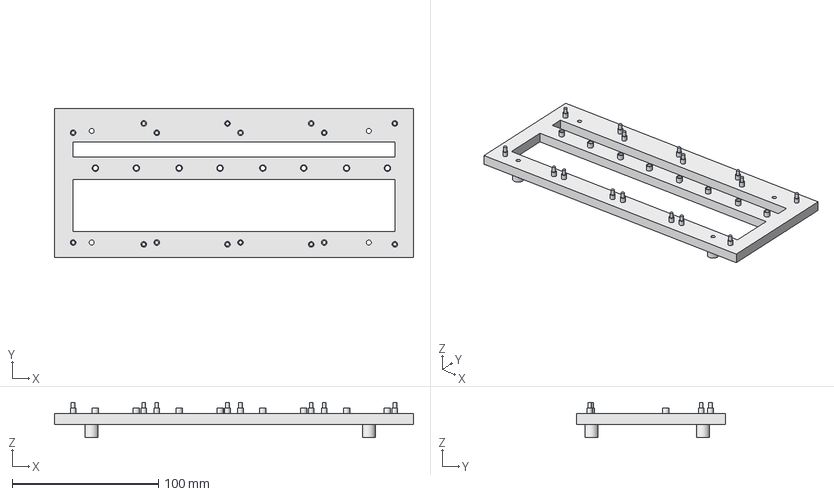
[picture p17: CAD file, 2020-04-12, an earlier design]
multi-ticc/enclosure/3d_print/multi-ticc-v1.FCStd
245.1 x 101.6 x 24.1 mm
