TAPR/TICC/(list of files, cad)

Other CAD files:
multi-ticc/enclosure/3d_print/multi-ticc_4_unit_frame.stl
