TAPR/TICC/docs/development_docs/HARDWARE_TESTING_SUMMARY.md

# SPI Optimization Testing - Complete Summary
Generated by AI -- No copyright claimed.  May be inaccurate, incomplete, or superceded 
by later development.  Use for reference only.

**Date:** October 14, 2025  
**Branch:** spi-timing-test  
**Status:** ✅ ALL TESTING COMPLETE

## Final Results - Production Recommendations

### SPI Read Optimizations (Proven Effective)

| Metric | Baseline | Optimized | Improvement |
|---|---|---|---|
| Isolated SPI reads | 236 µs | 132 µs | **-44%** |
| Real processing (no output) | 700 µs | 580 µs | **-17%** |
| Full cycle @ 115200 | 1.81 ms | - | N/A |
| Full cycle @ 230400 | 1.62 ms | - | N/A |

**✅ RECOMMENDATION: Implement both SPI optimizations in production**

### Complete Performance Characterization

**Test 9: Full Cycle with Output (Optimized)**
- **115200 baud:** 1.81 ms total (580 µs process + 1230 µs print)
- **230400 baud:** 1.62 ms total (580 µs process + 1040 µs print)

**Bottlenecks Identified:**
1. **Serial output:** 1.04-1.23 ms (64-68% of total) ← LARGEST
2. **64-bit math overhead:** ~100-150 µs (17-26% of processing)
3. **SPI reads:** 136 µs optimized, was 236 µs ← OPTIMIZED ✅
4. **Function overhead:** ~40-60 µs (7-10% of processing)

## All Tests Conducted

**SPI Optimization Tests (1-3):** TICC-to-TICC synthetic timing  
**Loop Benchmarks (4-5):** TICC-to-TICC idle and full loop  
**Scope Verification (6-7):** Oscilloscope pulse width confirmation  
**Live Processing (8a-d):** Oscilloscope with real signal, all optimization combos  
**Full Cycle (9a-b):** Oscilloscope with output at two baud rates  

## Key Findings for Production

### What to Implement
1. Auto-increment SPI mode (-13% in live conditions)
2. Direct CSB port manipulation (additional benefit when combined)
3. Combined effect: -17% processing time, -120 µs per measurement

### Future Optimization Opportunities
1. **64-bit math** (100-150 µs, 17-26%) - highest impact remaining
2. **Function inlining** (40-60 µs, 7-10%) - medium impact
3. **Binary mode** (saves 23 bytes, ~200 µs print time) - already exists

### Architecture Documentation Updates Needed
- Idle loop: 1.2 µs → 52 µs (measured)
- Processing: 164 µs → 580-700 µs (measured)  
- TDC SPI: 94 µs → 136-236 µs (measured)
- Print time @ 115200: ~1.7 ms → 1.23 ms (measured)
- Print time @ 230400: (new) → 1.04 ms (measured)

## Testing Branch Contents

**Instrumentation Code:**
- timing_test.h - TICC-to-TICC timing configuration
- timing_scope.h - Oscilloscope timing configuration
- Timing markers throughout code

**Documentation:**
- TIMING_TEST_README.md - TICC-to-TICC method guide
- SCOPE_TIMING_GUIDE.md - Oscilloscope method guide
- SCOPE_QUICK_START.md - Quick reference
- TIMING_TEST_RESULTS.md - All test data
- TESTING_COMPLETE_SUMMARY.md - This file

**Optimized Functions:**
- readReg24_autoincrement() - Auto-increment SPI reads
- Direct CSB macros in board.h
- Conditional compilation in read() function

## Next Steps

1. ✅ Testing complete - branch preserved via tag
2. ✅ Documentation added to main branch
3. → Create implementation branch
4. → Apply optimizations to production code
5. → Test with real measurements
6. → Merge to main when verified

---

**Recommendation:** The optimizations are thoroughly tested and ready for production use. Implement both for 17% performance improvement.
