TAPR/TICC/bin/verification/README.txt

These are programs that I used to verify the TICC firmware's operation and
performance.  Most of these were generated by AI tools.  They are not part of
the core TICC distribution and are provided for convenience only.  Use them
at your own risk!
