TAPR/TICC/docs/images/TDC7200-calibration-description.png

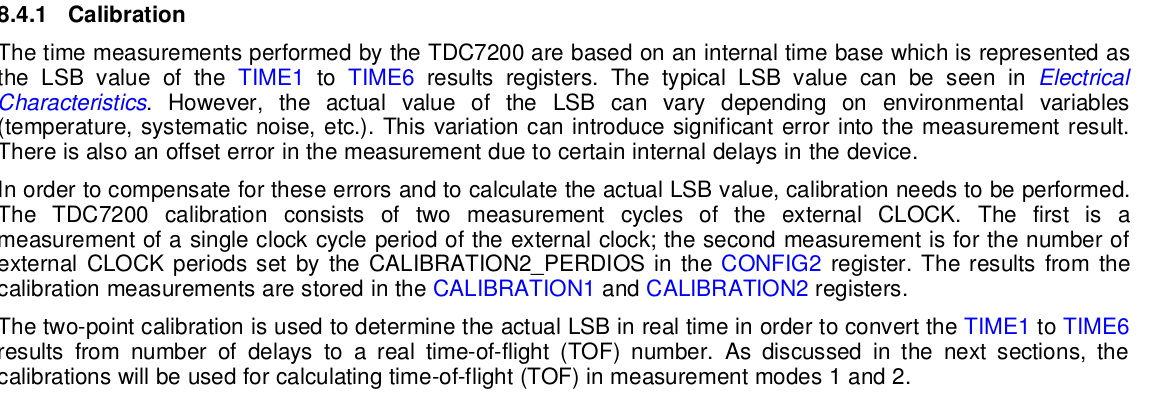
docs/images/TDC7200-calibration-description.png
