TAPR/TICC/(threads)

Thread 13 (2016-07-26):

Enhancement -- ringperiod resolution

n8ur, 2016-07-26:
Not urgent.

Currently, the calculation that determines the ring period has a result that is truncated to integer picosecond.  Since we are multiplying the introduced error by potentially a couple of thousand, it would be good to see if we can improve the precision to 0.1 or 0.01ps.
I think this can be done by the old multiply-then-divide trick in the ringperiod calculation, and combining that into a single statement with the following ringticks * ringperiod multiplication into the same step.  Final result can be integer picoseconds but want to improve the quality getting there.

Tom-McDermott, 2016-08-12:
Hi John - Just got back home last night - 8 days with no email access in
Canada (vacation).
Many emails to sort through...

Let me take a look through your code and try to run some off-line
analytical tests.

-- Tom, N5EG

On Mon, Jul 25, 2016 at 5:55 PM, John Ackermann N8UR <
notifications@github.com> wrote:

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

Tom-McDermott, 2016-08-12:
Found just a few code changes referenced by this issue, but none dealing with
the ring period resolution - The only branch found is master, so the others probably
have already been merged into master.  Perhaps the code changes were lost, or else
they were committed in a previous update.

John - could you point us to the section of code that you changed for this?

-- Tom

n8ur, 2016-08-12:
We should talk before you get too far... I've encountered a nasty that
needs to be addressed.  Will be working on it this weekend.  Maybe give
you a call tonight (remembering time difference) or Saturday?

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

n8ur, 2016-08-14:
Have increased precision of calculations, removing a major source of error.  Also added TIME_DILATION constant to allow fine adjustment of normLSB result.

Closed 2016-08-14.

Thread 14 (2016-08-05):

STOP gate glitch (Hardware)

n8ur, 2016-08-05:
Tom discovered that on some (but not all) boards, the stop gate hardware can latch to a HIGH state on one or both channels.  This causes the software to hang and the only way to clear is to pulse INTB low (open collector).  We can't cause the TDC chip to do this.

Only fixes appear to be either changing the board to allow an Arduino I/O pin to drive a transistor to pulse the INTB lines, or to test for inactivity on a channel and disable.  Tom's current code (to be committed here soon) provides that test.

For hardware Rev. D we need to consider the hardware fix.

n8ur, 2016-09-02:
Resolved by restructuring code.

Closed 2016-09-02.

Thread 15 (2016-08-05):

Using Arduino I/O 13 (Hardware)

n8ur, 2016-08-05:
The STOPB signal (from stop gate for channel B) uses Arduino I/O pin 13.  I just noticed that pin 13 is attached to a resistor and LED, which provides a handy signal but might cause timing or other differences between channels.

For Rev. D board, should we change to another I/O pin, and leave 13 unused?

n8ur, 2016-11-27:
Rev. D changes the STOPB signal from D13 to D3 (STOPA is D2).  This is a true HW interrupt pin, not a PC interrupt so might be a little faster now.

Closed 2016-11-27.

Thread 16 (2016-08-14):

Is time2Result really variable

n8ur, 2016-08-14:
The time2Result register reflects the time from the STOP pulse generated by the stop gate circuit until the next edge of the 10 MHz clock.  This ought to be a fixed interval determined by propagation delays, and investigation seems to show that it is.  Attached is a plot of the time2Result run through the normLSB (ps per tick) calculation for about 90 minutes.
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

Running statistics on the raw time2Result integer value, over that run we get:

Min:         1123
Max:        1127
Mean:      1124.88
STDDEV: 0.36

There is no apparent trend in the result (i.e., the dominant value is the same at both ends of the run).  So the value seems to be stable over this run, and including its instantaneous value in the calculation only adds noise.  What if we either: (a) do a calibration at restart that measures the first say 10 time2Result measurements and determines the integer mean, then uses that fixed value going forward, or (b) use a rolling average of time2Result instead of the instantaneous result?  This could be a configurable option.

If we can remove the time2Result jitter, I think we reduce the overall jitter by half, which is a nice win.

UPDATE:  The latest commit adds a "FIXED_TIME2" constant.  If set to 0, calculation operates as before.  If nonzero, that value substitutes for time2Result in the calculation.  I set to 1125 (the integer mean from the run above) and in an initial test, it seems to reduce the 1 second ADEV (which sort of represents jitter) by about sqrt(2), which makes sense and is a worthwhile improvement if it's valid.

n8ur, 2016-08-17:
In setting up another test, I noticed that after I had interrupted the 10 MHz clock to change to another source, the time2Result has changed to something around 1350.  It may be that the phase relationship between 10 MHz clock and 100us tick changes each time the PIC divider starts.

So calculating the mean time2Result value once and storing it away may not be the right answer.  Instead, maybe we should have an optional cal cycle at the beginning of measurement to get the value which is used for that run.

Closed 2017-02-14.

Thread 20 (2016-09-04):

Values to save in eeprom

n8ur, 2016-09-04:
We should move as much config as possible from constants, to variables stored in eeprom so the user can change without needing to recompile.  Here's my first pass at var, type length (bytes), index position:

SERIAL                char[11]     0    // board serial number (10 char); can we set once then protect?
CLOCK_HZ             uint32    11    // clock speed -- default 10 000 000
PICTIC_PS             uint32    15    // 100 000 000 for 100us
CAL_PERIODS         uint8    19    // calibration periods
TIME_DILATE_0     uint32    20    // time dilation factor channel 0
TIME_DILATE_1     uint32    24    // time dilation factor channel 1
FIXED_STOP_0      uint32    28    // do we autocal, and if so the stored value
FIXED_STOP_1      uint32    32    // do we autocal, and if so the stored value
FUDGE_0               uint32    36    // fudge factor channel 0
FUDGE_1               uint32    40    // fudge factor channel 1
MODE                      uint8    44    // operating mode

I thought about including firmware version, but we can compile that into the firmware itself by setting it as an array of char[].  No need to store in eeprom then.

ghbyrkit, 2016-09-04:
John,
You likely want to have an 'eeprom data layout version byte' at the start.  The reason is: you may update the layout by adding things at the end, or deprecating things in the middle.  This way the firmware knows if the eeprom data layout is compatible, needs to be extended, some settings redone, etc.

George

-----Original Message-----
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

n8ur, 2016-09-04:
Great idea, George.  I wouldn't have thought of that, but I'm guessing
you've had some experience in that regard. :-)

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

ghbyrkit, 2016-09-04:
Just a little experience in this area...

George

-----Original Message-----
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

n8ur, 2016-11-27:
EEPROM config storage is implemented, with version number as suggested by George.

Closed 2016-11-27.

Thread 22 (2016-09-08):

Future Plans: better throughput, more measurements/second

n8ur, 2016-09-08:
Without any optimizing (and using i64_t way more than is probably necessary, and Arduino that's really slow), the time inside the TICC measurement loop from "got data" to end of calculation is around 500us.

However, printing over USB takes 1 to 5ms.  From some Googling I've learned that the following may be bottlenecks:

1.  The "Serial.print" function is very inefficient.  Using "Serial.write" might be faster, but we have to send it the data character-by-character.

2.  USB packetizes data and sends variable length packets of up to 4K once per millisecond.  So there's latency waiting for the next slot, and if the data crosses packets there's further delay.

I've also found or thought of a couple of possible solutions:

1.  Use Serial.write -- probably not a big win if you still have USB latency.

2.  Buffer the print requests so that we don't send on each measurement, but build up until we can send a burst.  We do *not* need real-time data output; if a burst arrives every 10 seconds, I don't think that's a problem.

3.  Use one of the other UART ports on the Mega CPU for output.  This would require an added TTL to RS-232 converter.  It would get rid of USB latency, but may have other overhead or bottlenecks (I'm not clear whether only serial port 1 is hardware UART and the others may involve more bit banging).

4.  Use SPI to send data to another Arduino, which would buffer it to send out in large packets and could also do other cool things like drive an LCD front panel.  I kind of like this idea as presumably the SPI would be able to move the data out pretty darn quickly, and we already have the SPI code in the program.

Thoughts?

Tom-McDermott, 2016-09-11:
Hi John - let me try to answer some parts.

1. When passed a string, Serial.print basically just calls Serial.write. There's not much difference performance-wise. Printing a float is where Serial.print is inefficient.  Our code creates a string out of the float by using printf. I suspect that printf and Serial.print are roughly similarly inefficient.

2. USB 2.0 packetizes 1024 bytes/frame. However I don't think the Arduino has any added processing as the buffer is passed to the 16U2, which queues it and completes the USB transfer independently from the 2650 processor.  Any delay here is in when the characters hit the host computer (latency about which we don't care).

For the solutions:

2. All 4 of the serial interfaces on the Mega2650 each have only a one-byte hardware buffer. The Arduino serial library puts the transmit characters into a 64-byte ring buffer then returns. The library uses interrupts to clock out the contents of that 64-byte buffer. If You try to put more than 64 bytes into the buffer, then the Serial.write (or print) call blocks, and all other processing stops until it drops to below 64 bytes in the buffer again.

3. I don't think things improve by choosing a different serial output as the 16U2 offloads most or all of the USB work. Other ports have the drawback that the host computer would need a serial interface.

The key to speeding up the measurement cycle it to reduce the time the 2560 spends in the compute/format loop. As long as the transmit buffers stay below 64 bytes, I *think* the serial Tx is outside the critical path (i.e. handled by interrupts).

4. We could use SPI to another Arduino. The question is: does that actually reduce the time in the critical processing loop?    I'm not convinced that it would, but it might.

-- Tom, N5EG

arodland, 2017-02-25:
The Mega has 4 hardware UARTs that are all the same. (That's one of its big advantages over the smaller boards). The USB-to-serial conversion is handled on a separate chip that's wired up to UART0; the CPU doesn't see any of it. In fact if you want to ignore USB and use serial you can do it right now by unplugging the USB, applying power to Gnd and 5V (or Gnd and Vin), and hooking up TTL serial to pins 0 and 1. And I agree with Tom about Serial.print, it's not likely to be your bottleneck.

In fact, I wouldn't be surprised at all if the most expensive thing is simply all of the 64-bit arithmetic (especially the divisions) in print_signed_picos_as_seconds. Not sure how much improvement is available there, but I think it's at least some.

Another thing worth trying is eliminating all of the digitalRead and digitalWrite in the measurement loop. Those functions have a bunch of overhead due to checks needed for beginner-friendliness (look up the port number and mask in a table of pin numbers, make sure it's a valid pin number, see if it's doing PWM, etc.). It's possible to bypass all that for performance, and may be worth it here.

n8ur, 2017-02-26:
Thanks, Andrew.

You're confirming what I gathered after the bit of research I was able
to do.

I have two ideas that separately or together might get around the 64 bit
bottleneck, but haven't had time to fully think through either of them:

1.  Don't do math or print results at 1 picosecond resolution, but at 10
ps.  That reduces scaling at the small end by an order of magnitude, and
shouldn't cost anything given 60-70 ps of noise.  Then maybe int32 is
big enough for practical purposes.

2.  Process and print the integer and fractional part of the result
separately, each as a native 32 bit, e.g.,

Serial.print(integer_part);Serial.print(".");Serial.println(fractional.part)

That requires converting PICstop (count of 100us ticks) into two
variables: integer seconds, and n*0.0001, then subtracting the
time-of-flight variable and deal with any rollovers that result.  Can
all that be done with less overhead than the current approach?  I have
no idea.

John
----
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

arodland, 2017-02-27:
Option 2 is very likely to help if done right. Division is pretty much the most expensive operation on a microcontroller, and it gets exponentially slower the further you go beyond the native word size (which is only 8 bits for AVR). If you can stop the values from getting so large in the first place, even at the cost of having more variables, and even at the cost of doing a division earlier on (but with smaller quantities) you can easily win.

n8ur, 2017-02-27:
Attached is sample code for an int32-based printout routine.  Not
tested, but would appreciate review for dumb logic/math errors.

This moves a little more work into the ISR, but the benefit is there is
no division required at all, at least to do the printing.

Note that we will still need to multiply and divide at 64 bits in the
tdc read function in order to get sufficient resolution in the
time-of-flight calculation.

The timestamp() function returns integer picoseconds in an int64_t
because the time interval and period routines depend on timestamp math.
  But we're still left with the problem of printing those int64 results,
so more thought is needed.  But at least this is a start.

Is this on the right track?

John
----

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

n8ur, 2017-02-27:
[print.txt](https://github.com/TAPR/TICC/files/804083/print.txt)

arodland, 2017-03-01:
int32_t frac = PICstop_usec * 1000000; // mult by 1e6 to make picos

I think this number is off, if PICstop_usec is actually 100us ticks, you want to multiply by 1e8, not 1e6.

Either way, you need an int64_t at this point, or you will exceed the range of int32_t (+/- about 2e9). Picoseconds are tough, we can't even fit one second worth of them in a 32-bit int.

But as demonstrated by tof, the number of picos in a 100us tick *does* fit comfortably in an int32, and it's a nice decimal division (meaning you can be clever with print routines; instead of multiplying, adding, and printing, you can just print the two values back-to-back if you make sure to zero-pad the second one). So I would suggest dividing things up along those lines, as a `struct timestamp { int32_t sec; uint16_t ticks; uint32_t ps; }` (80 bits, with the decimal point located convenently between two quantities, time range over a hundred years). Adding and subtracting them would be done through (relatively cheap) library functions that add/subtract corresponding parts and deal with carry/overflow.

I admit it seems a bit complicated, but it could be done up pretty tidily, and the next simpler option that I see (that of `struct { int32_t ticks; uint32_t ps; }`) only covers a range of about 5 days which would become inconvenient during long measurement runs.

I'm willing to make an attempt at doing it, if you think it's something you would want to maintain. It's the sort of thing I enjoy playing with anyhow.

n8ur, 2017-03-01:
I'd love it if you'd take a whack at that, Andrew!

And you're right about 1e8, of course.

Thanks!

John
----

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

n8ur, 2017-03-02:
It's been mentioned that baud rate imposes a basic limit on throughput.  I've been using 115200 as that is the maximum speed of the Arduino IDE terminal window, but the hardware apparently supports up to 2mb.  I just did a test of the current code with the "DETAIL_TIMING" flag set in TICC.ino, and found that 230400 worked just fine and 576000 worked with some garbles.  But neither one resulted in reduced execution time.  So I think that at present we are compute, and not wire, bound.

n8ur, 2017-03-03:
Andrew, not sure I replied to this, but I did do macros for LED control.
  Don't know if they make much difference over digitalWrite(), but I'll
take what I can get.

John
----

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

arodland, 2017-03-07:
Status update: I found some time to work on this over the weekend. I refactored timestamps the way I suggested in my earlier comment, got everything working, and ended up with execution times that were almost exactly the same as before. I'll investigate more to try to figure out where the time is really being spent.

n8ur, 2017-03-09:
That's interesting...

I just made a change (version 20170308.1) that might help with
profiling.  The new version I just pushed to main adds a "Null Output"
mode that goes through all the motions but doesn't format or output the
result.  Setting that mode, plus uncommenting DETAIL_TIMING, should
provide better ability to see the speed of the loop without serial
output overhead.

A very quick test indicates that with a single channel active, time to
get and calculate a result is about 650ms, but the total time through
the loop is about 1100ms -- almost half the time is spent not doing
useful work.  I haven't had a chance yet to look for where that time is
being spent.

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

n8ur, 2017-03-09:
Serial.print() statements in the DETAIL_TIMING debug code were swamping the actual execution time.  I just pushed 20170309.1 which just prints total execution time (micros) with nothing else and that cut down (but did not completely eliminate) the overhead.  That in conjunction with the "NULL" measurement mode should allow better profiling -- toggling between NULL and TIMESTAMP mode should show the result formatting/output overhead.

arodland, 2017-03-10:
That's great! I'll rebase my work on top of this and see what comes out.

arodland, 2018-04-18:
I suppose this is dead, it's been over a year. The changes I made *worked*, but contrary to expectation, made absolutely no difference to the performance of the code, and I couldn't get to the bottom of why. I'll try to find my code and push it up in case anyone wants to look into it in the future.

Thread 25 (2017-03-16):

No recovery from loss of 10 MHz frequency reference

wowczarek, 2017-03-16:
Currently, when 10 MHz is lost and restored, TICC does not resume measurement and stalls until it is reset, regardless of measurement mode. I have not looked into the source code yet so I appreciate that this may not be trivial to solve, but I thought I should flag this anyhow.

n8ur, 2019-10-29:
I am not sure anything can be done about this, short of a restart.  When the 10 MHz clock goes away several timing signals disappear and on recovery the relative phase of those signals may change.  And the timescale will jump in a way that's not apparent in the output.  Say the clock goes away after timestamp 101.something of a PPS signal.  When the clock comes back, the next timestamp will be 102.something.  The data will show a 1 second step but the actual gap could be milliseconds to years.

The only practical way to recover, I fear, is to reset and start again.

wowczarek, 2019-11-28:
Hi John,

Understood; thank you for checking this. However can this condition be detected and (whether it is a sane thing to implement or not), the way the board is laid out, can it trigger its own reset, or will a software reset re-initialise all hardware? I suppose one of the free pins could always be wired to reset, watchdog-like. I sincerely cannot recall right now whether re-connecting to serial does resume the normal operation after loss of 10 MHz or not - my TICs run for weeks or months at a time so it has been a while since I deprived them of REF.

n8ur, 2019-12-02:
Re detecting loss of ref clock.

I just pushed a bug fix to the multi_ticc branch that might enable what you want to do, with a bit of extra hardware.

Arduino output A11 (assigned in the software to EXT_LED__CLK) is intended to turn on an LED if the coarse counter is incrementing properly.  It tests for PICcount to increment at least every 250 us and if that doesn't happen, the LED is turned off.  That would result on a master board from loss of 10 MHz reference, failure of the PIC divider, or possibly other issues.  On the slave board, I don't think loss of 10 MHz would do it, but loss of the external COARSE_CLK signal from the master would.

You could sense the state of A11 and if it goes low, use that to pulse the reset line low and reset the Arduino.  After restart A11 will stay low for at least a couple of seconds as the board initializes, so you'll need to do something to hold off sending additional reset pulses until A11 has had a chance to go high again.

The test doesn't work in the current main branch because I forgot to set A11 to OUTPUT mode.  That's fixed in what I just pushed to multi_ticc.

I haven't tried this so don't know if it would work in practice.

Thread 26 (2017-03-21):

Feature request for consideration: fudge1

wowczarek, 2017-03-21:
It would be useful to have two sets of fudge values for both channels that would be compounded during measurement: fudge0 can be used as internal correction for precise calibration of the TICC + cabling / pigtails, and fudge1 can be used as the working correction for whatever the user is currently doing. Having two separate corrections would spare us some extra math and having to remember the original correction value.

n8ur, 2019-10-29:
Again, sorry for the long update cycle, but the updated code will address this issue.

Closed 2025-09-05.

Thread 27 (2017-03-21):

Feature request for consideration: Board name / ID string

wowczarek, 2017-03-21:
When building a bigger system out of multiple TICCs, it would be useful to be able to set an n-character ID of each board. When multiple TICCs are connected to a USB host, they may be detected in a semi-random order, and serial devices are not always detected under the same name. A board ID would allow one to scrape the output for the ID and identify which board is which.

n8ur, 2019-10-29:
I know this is old, but I'm (finally) working on an update to the TICC code and am implementing something that will provide this capability.

wowczarek, 2019-11-28:
Thank you - I have my master-slave TICs mapped by serial number, so that works, and I suppose it's a similar amount of work for the operator to either map the serials in an external system or set an ID within the TICs...

Thread 30 (2020-06-24):

Channel readings out of order

germanh1982, 2020-06-24:
Hi

When using the TICC with both channels simultaneusly and the channels' relative phase is low enough, the TICC spits out the readings in an order different than the relative time of each event:

# timestamp (seconds)
0.439584593247 chA
0.439582179116 chB
0.689584594560 chA      <--- This row and the next are out of order, for example
0.689582177550 chB      <---
0.939582176044 chB
0.939584595875 chA
1.189584597191 chA
1.189582174452 chB
1.439582172960 chB
1.439584598507 chA
1.689582171446 chB
1.689584599821 chA
1.939582169811 chB
1.939584601135 chA
2.189584602511 chA
2.189582168244 chB
2.439584603827 chA

This doesn't seem to happen when the relative phase difference between the inputs doesn't let the event times between channels get close. During this situation, the readings come out in order, as far as I can tell.

The issue causes Timelab to confuse the input readings, because of the way the channels are configured and interpreted in the software: for each reading cycle, chA is the first reading and chB goes after chA. I understand this is also an issue with Timelab, because it shouldn't expect that the reading are always in order.

I'm not sure whether this is a Timelab bug or the TICC firmware. I understand that by having two independent inputs there's no way to ensure that the channel readings will come out in order, but I'm referring to the cases where the inputs do come out of order: Is there anything that can be done in order to avoid it from happening?

Attached is a phase difference plot from Timelab, where the issue shows.
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

Also, the phase data files used to obtained these graphs:
[phase-data-issue.txt](https://github.com/TAPR/TICC/files/4827907/phase-data-issue.txt)
[phase-data-ok.txt](https://github.com/TAPR/TICC/files/4827908/phase-data-ok.txt)

Let me hear your comments
BR, German

n8ur, 2020-06-24:
Hi German --

This is a known situation (I hesitate to call it an issue or a bug,
because it's complicated).  There are two things going on, one if which
can probably be mediated and the other not.

The big problem is that you can *never* guarantee that the two channels
will always come out in "ABAB" order because there are many perfectly
legitimate conditions where that sequence doesn't occur -- including
only one channel in use, channels running at different rates, or time
interval between them being so small that noise or drift causes them to
cross.  There's no way to automatically deal with those situations in
the code.

The second phenomenon is in the nature of the way the TDC-7200 chip in
the TICC works.  Without going into gory details, if the two channels
trigger within a short (probably < 100 us, but I haven't fully verified
that) period, there's no guarantee which chip's output will first be
processed by the Arduino, so you could get outputs that are out of
order, resulting in what you show in your snippet.

There's no way to fix this behavior, but I think it's possible for the
Arduino processing loop to check each result to see if its timestamp is
earlier than a prior one, and if so flip the output order.  I plan to
implement that as soon as I have some cycles free.  If it works, it will
ensure that the TICC will always output timestamps in increasing order
and solve some of the instances of "ABBA" output.  But again it can't
solve the first problem.

John
----

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

germanh1982, 2020-06-25:
John, thank you for your quick response.
Yes, I understand that dealing with the synchronization of the output for naturally asynchronous, and possible different frequency, events is not an easy task to deal with.
Your response was very enlightening, keep up the great work, the TICC is a wonderful little device!

Cheers

citizenrich, 2020-06-25:
If you folks don't mind a quick observation here. I use Lady Heather to control the TICC. And recently, the maintainer of Lady Heather noted on the time-nuts mailing list that "Lady Heather's TICC parser does not expect alternating ABAB readings and handles the ABAB vs ABBA situation properly." Maybe that's an option for then exporting and importing into TimeLab.

germanh1982, 2020-06-25:
> I hope you folks don't mind a quick observation here... I use Lady Heather to control the TICC. And recently, the maintainer of Lady Heather noted on the time-nuts mailing list that "Lady Heather's TICC parser does not expect alternating ABAB readings and handles the ABAB vs ABBA situation properly." Maybe that's an option for then exporting and importing into TimeLab.

That's a good suggestion of which I didn't know, but sadly it doesn't work in my case because I'm running the TICC connected to a headless mini-PC, no GUI, only SSH access for configuration, and telnet service for the connection from TimeLab.
For now I'm overcoming the situation by buffering the stream from the TICC in a script in realtime and reordering the output by timestamp, like John's approach but doing it on the mini-PC instead of the TICC.

Cheers!

n8ur, 2020-06-25:
I saw that note from Mark, and I'm glad he did that.  I don't know whether it's easier to export via LH than other methods.  It's possible TimeLab may incorporate its own solution, but JohnM has lots on his to-do list.

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

n8ur, 2020-06-25:
Look at TimeLab's "read from live ASCII file" option if you want real-time plotting.  Use a command-line tool to split the data stream into one disk file per channel, then open two capture streams in TimeLab, one reading each of those files.

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

Closed 2020-06-25.

Thread 32 (2020-10-01):

ticc based on more modern mcu

robots, 2020-10-01:
Hi,

i have made "copy" of the hardware to make it self contained and not Arduino based. Its based on stm32f042 mcu with frontend unchanged.

https://github.com/robots/stm32-ticc/

have fun

n8ur, 2020-10-06:
Very cool!  Thanks for letting me know.

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
