TAPR/TICC/multi-ticc/enclosure/images/multi-TICC_mounting_hole_dimensions.pdf

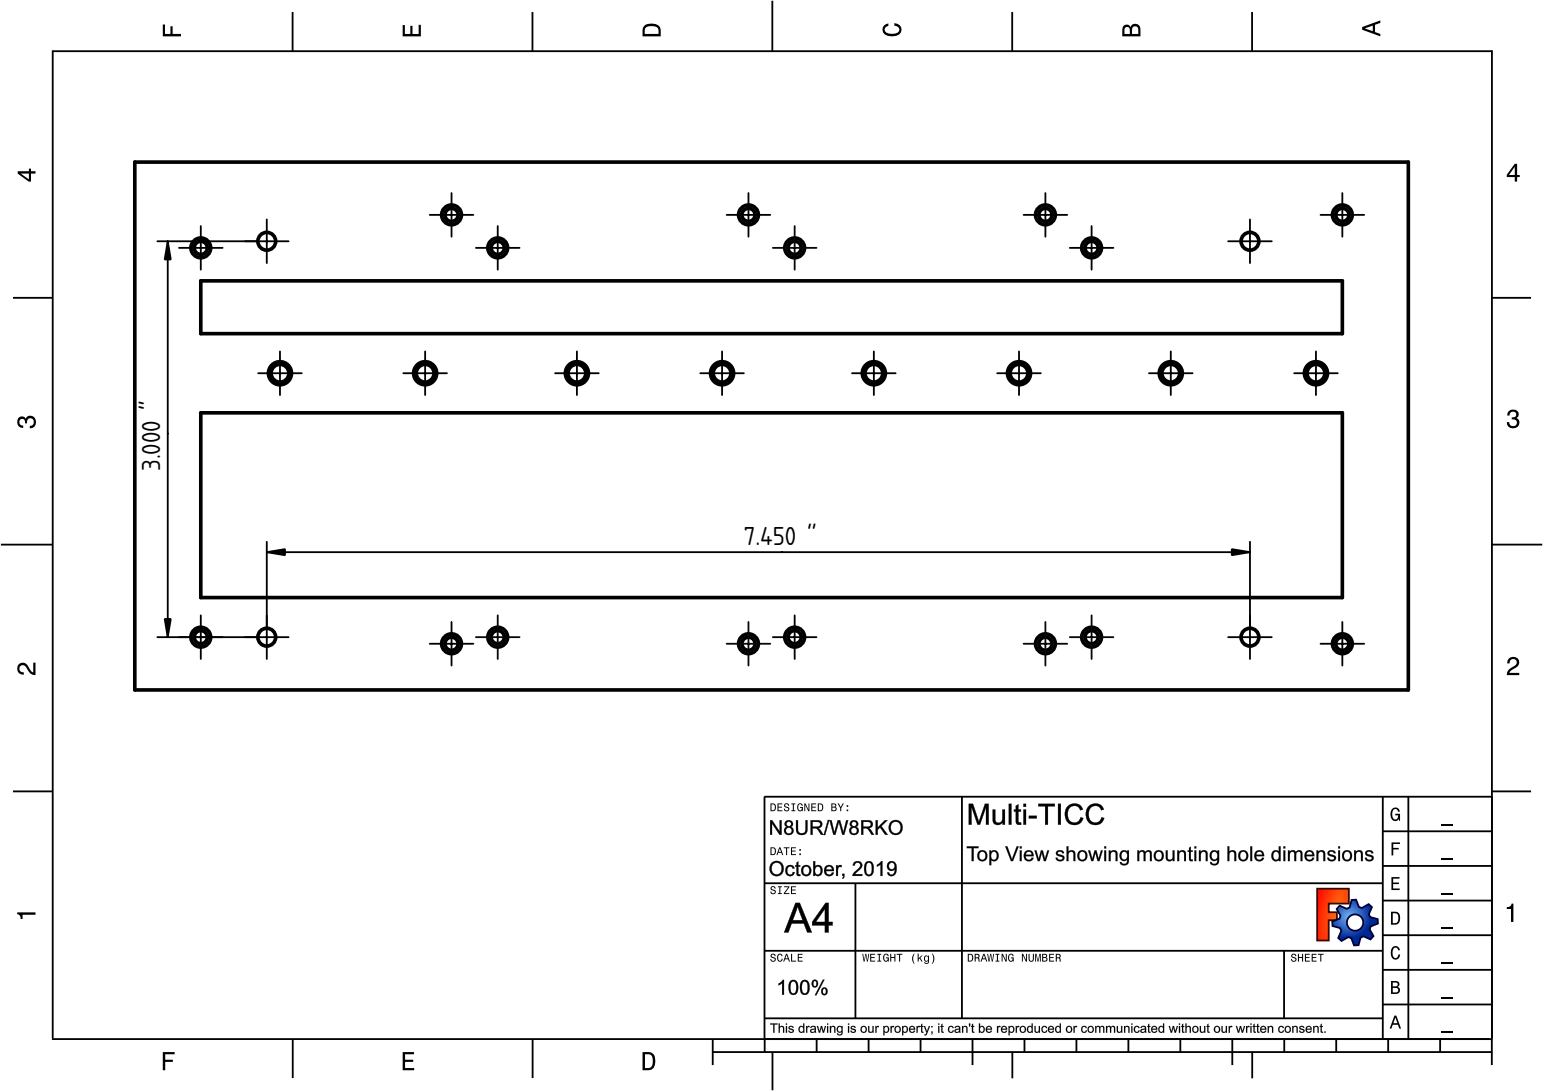
[picture p38: page 1]
