TAPR/TICC/multi-ticc/rpi_files/multi-ticc_server.py

#!/usr/bin/env -S python3 -u
# note: -u for unbuffered stdout

###############################  N8UR multiTICC  ###############################
#########################   multi-ticc_server.py    ############################
#
#	Copyright 2019, 2020 by John Ackermann, N8UR
#       jra@febo.com https://febo.com
#
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
################################################################################

import sys
import time
import queue
import threading
import logging
import socket
import time
import serial       # install python3-serial
import argparse     # install python3-argparse
import gpiozero     # install python3-gpiozero         

################################################################################
version = '20201109.1'

# BASE_PORT carries multiplexed unsorted data
# BASE_PORT + 1 carries multiplexed sorted data
# BASE_PORT + N carries channel (N-2) data
BASE_PORT = 9190

# placeholder
HOST = '0.0.0.0'

# Serial interface speed
BAUD_RATE = 115200

# List of device names
DEVICES = ['/dev/ttyTICC0','/dev/ttyTICC1','/dev/ttyTICC2','/dev/ttyTICC3']

# List of channel names
CHANNELS = ['chA','chB','chC','chD','chE','chF','chG','chH']

###############################################################################
# Functions
###############################################################################
def get_opts():
    # get params; use default if not specified on command line
    a = argparse.ArgumentParser()
    a.add_argument('--comports',nargs='*',type=str, default = DEVICES)
    a.add_argument('--chnames',nargs='*',type=str, default = CHANNELS)
    a.add_argument('--baseport',type=int,default = BASE_PORT)
    a.add_argument('--baudrate',type=int,default = BAUD_RATE)

    args = a.parse_args()

    global hwports, channels, base_tcp_port, baudrate
    hwports = args.comports
    channels = args.chnames
    base_tcp_port = args.baseport
    baudrate = str(args.baudrate) # convert to string for serial object

def get_data(s,q):
    min_line_length = 18  # serial line shorter than this is bogus
    # get first possibly partial line and throw away
    line = s.readline()
    while True:
        try:
            line = s.readline().decode('ascii').strip()
            # ignore comments and short lines
            if (not line.startswith('#')) and (len(line) >= min_line_length):
                if not q.full():
                    q.put(line)
        except serial.SerialException:
            msg = "Oops serial port error: " + sys.exc_info()[0]
            logging.error(msg)
            sys.exit(1)

def ch_handler(channels,inqueue,qlist):
    while True:
        line = inqueue.get()
        if line is None:
            break
        if not qlist[0].full():
            qlist[0].put(line)
        if not qlist[1].full():
            qlist[1].put(line)
        for index,x in enumerate(channels):
            if x in line:
                if not qlist[index + 2].full():
                    qlist[index + 2].put(line)
        inqueue.task_done()
    
def demuxed_port_listener(base_tcp_port,index,q,channels):
    tcp_port = base_tcp_port + index
    msg = "Listening and ready to send " + str(channels[index - 2]) + \
        " on port " + str(tcp_port)
    logging.info(msg)

    while True:
        s = socket.socket(socket.AF_INET,socket.SOCK_STREAM)
        s.bind((HOST, tcp_port))
        s.listen(1)
        while True:
            conn, addr = s.accept()
            msg = "Client connection accepted from " + str(addr)
            logging.info(msg)
            try:
                # empty the queue so we don't have gaps in data
                while not q.empty():
                    q.get(False)
                while True:
                    line = q.get()
                    if line is None:
                        break
                    line = line + '\n'
                    line = bytes(line,'ascii')
                    conn.send(line)
                    q.task_done()
            except socket.error as msg:
                msg = "Client connection closed by " + str(addr)
                logging.info(str)
                conn.close()
            conn.close()

def muxed_port_listener(tcp_port,q):
    msg = "Listening and ready to send multiplexed data on port " + \
            str(tcp_port)
    logging.info(msg)

    while True:
        s = socket.socket(socket.AF_INET,socket.SOCK_STREAM)
        s.bind((HOST, tcp_port))
        s.listen(1)
        while True:
            conn, addr = s.accept()
            msg = "Client connection accepted from " + str(addr)
            logging.info(msg)
            try:
                # empty the queue so we don't have gaps in data
                while not q.empty():
                    q.get(False)
                while True:
                    line = q.get()
                    line = line + '\n'
                    line = bytes(line,'ascii')
                    conn.send(line)
                    q.task_done()
            except socket.error as msg:
                msg = "Client connection closed by " + str(addr)
                logging.error(msg)
                conn.close()
            conn.close()

def sorted_port_listener(tcp_port,q):
    msg = "Listening and ready to send sorted data on port " + str(tcp_port)
    logging.info(msg)

    while True:
        s = socket.socket(socket.AF_INET,socket.SOCK_STREAM)
        s.bind((HOST, tcp_port))
        s.listen(1)
        while True:
            conn, addr = s.accept()
            msg = "Client connection accepted from " + str(addr)
            logging.info(msg)
            try:
                # empty the queue so we don't have gaps in data
                while not q.empty():
                    q.get(False)
                while True:
                    # this is a priority (sorted) queue, so keep a
                    # minimum size so we can successfully sort the output
                    if q.qsize() > 20:
                        line = q.get()
                        line = line + '\n'
                        line = bytes(line,'ascii')
                        conn.send(line)
                        q.task_done()
            except socket.error as m:
                msg = "Client connection closed by " + str(addr)
                logging.error(msg)
                conn.close()
            conn.close()

###############################################################################
# Main routine
###############################################################################
def main():

    logging.basicConfig(level=logging.INFO, format='%(message)s')

    print()
    msg = "N8UR multi-ticc_server.py -- version " + version
    logging.info(msg)
    print()

    # get arguments
    get_opts()

    # reset the TICCs
    pin21 = gpiozero.OutputDevice(21)
    logging.info("Sending reset pulse...")
    pin21.on()
    time.sleep(0.1)
    pin21.off()
    pin21.close
    logging.info("Sleeping for 10 seconds to allow reset...")
    time.sleep(10)

    # open serial ports using a thread for each; dump into serqueue
    serports = []
    serthreads = []
    serqueue = queue.Queue(20)
    for x in hwports:
        try:
            msg = "Attempting to open " + x + "..."
            logging.info(msg)
            p = serial.Serial(x,baudrate)
            serports.append(p)
            thread = threading.Thread(target=get_data, 
                args=(p,serqueue),daemon=True)
            thread.start()
            serthreads.append(thread)
        except serial.SerialException:
            msg = "Oops... error" + sys.exc_info()[0] + \
                "occured opening" + x + "!"
            logging.error(msg)
            sys.exit(1)

    # make output queues
    ch_queues = []
    # First is a multiplexed queue with all data, FIFO
    ch_queues.append(queue.Queue(5))

    # Next is a priority queue to dump channel data in time
    # sequence so we make it a bit bigger to allow for sorting
    ch_queues.append(queue.PriorityQueue(50))

    # then add a queue for each channel
    for x in channels:
        ch_queues.append(queue.Queue(5))

    # start the handler that dumps data into proper queue
    ch_queues_thread = threading.Thread(target=ch_handler,
        args=(channels,serqueue,ch_queues),daemon=True)
    ch_queues_thread.start()

    # listen and dump data to tcp_port on connection
    sockthreads = []
    for index,x in enumerate(ch_queues):
        if index == 0:
            thread = threading.Thread(target=muxed_port_listener, 
                args=(base_tcp_port,x),daemon=True)
        if index == 1:
            thread = threading.Thread(target=sorted_port_listener, 
                args=(base_tcp_port + 1,x),daemon=True)
        if index > 1:
            thread = threading.Thread(target=demuxed_port_listener, 
                args=(base_tcp_port,index,x,channels),daemon=True)
        thread.start()
        sockthreads.append(thread)

    while True:
        try:
            time.sleep(0.01)
        except KeyboardInterrupt:
            logging.info("\nExiting...")
            for x in serports:
                x.close()
            sys.exit(0)

    for x in serports:
        x.close()
    sys.exit(0)

if __name__ == '__main__':
    main()
