TAPR/TICC/(notices)

Notices in the files:
multi-ticc/rpi_files/multi-ticc_server.py:
This program is free software; you can redistribute it and/or modify
it under the terms of the GNU General Public License as published by
the Free Software Foundation; either version 2 of the License, or
(at your option) any later version.
